TanvKT/DroneProjectHardware/README.md

# DroneProjectHardware
PCB schematic and design for Drone Project
