TanvKT/DroneProjectHardware/Controller/Controller.kicad_pcb

## KiCad design Controller/Controller.kicad_pcb (2026-02-24)

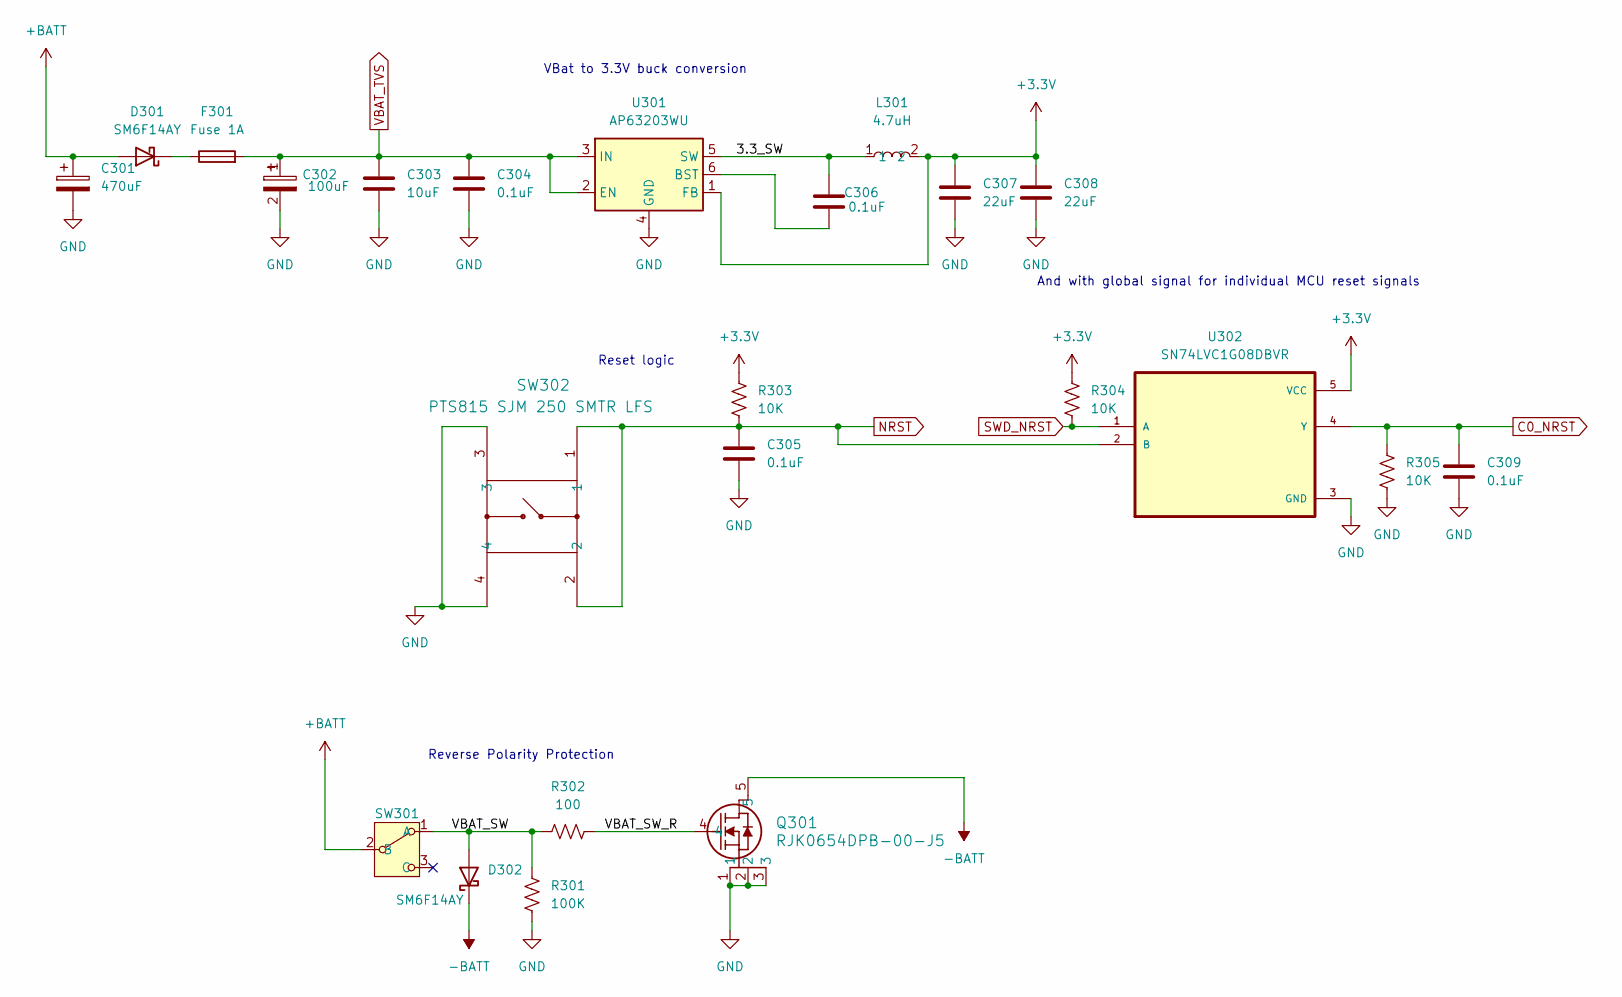
[picture p1: schematic Power.kicad_sch]

Parts:
C301: 470uF; CP_Elec_10x10.5
C302: 100uF; CAP_A768EB_6.8x6.8_KEM
C303: 10uF; C_1206_3216Metric
C304, C305, C306, C309: 0.1uF; C_0402_1005Metric
C307, C308: 22uF; C_0603_1608Metric
D301, D302: SM6F14AY; D_SOD-128
F301: Fuse 1A; Fuse_1812_4532Metric
L301: 4.7uH; IND_VLS6045EX-4R7M_TDK
Q301: RJK0654DPB-00-J5; LFPAK_REN
R301: 100K; R_0402_1005Metric
R302: 100; R_0201_0603Metric
R303, R304, R305: 10K; R_0402_1005Metric
SW301: SW_EG1218
SW302: PTS815 SJM 250 SMTR LFS; SW4_PTS815 SJM 250 SMTR LFS_CNK
U301: AP63203WU; TSOT-23-6
U302: SN74LVC1G08DBVR; SOT95P280X145-5N

Connections:
+3.3V: C307.1, C308.1, L301.2, R303.2, R304.2, U301.1 (FB), U302.5 (VCC); also elsewhere on the board
+BATT: C301.1, D301.2 (A), SW301.2 (B); also elsewhere on the board
-BATT: D302.1 (K), Q301.5; also elsewhere on the board
/Power/3.3_SW: C306.2, L301.1, U301.5 (SW)
/Power/VBAT_SW: D302.2 (A), R301.1, R302.1, SW301.1 (A)
/Power/VBAT_SW_R: Q301.4, R302.2
C0_NRST: C309.1, R305.2, U302.4 (Y); also elsewhere on the board
GND: C301.2, C302.2, C303.2, C304.2, C305.2, C307.2, C308.2, C309.2, Q301.1, Q301.2, Q301.3, R301.2, R305.1, SW302.3, SW302.4, U301.4 (GND), U302.3 (GND); also elsewhere on the board
NRST: C305.1, R303.1, SW302.1, SW302.2, U302.2 (B)
unnamed: D301.1 (K), F301.1
unnamed: C306.1, U301.6 (BST)
SWD_NRST: R304.1, U302.1 (A); also elsewhere on the board
VBAT_TVS: C302.1, C303.1, C304.1, F301.2, U301.2 (EN), U301.3 (IN); also elsewhere on the board

Notes on the sheet:
Reverse Polarity Protection
VBat to 3.3V buck conversion
And with global signal for individual MCU reset signals
Reset logic

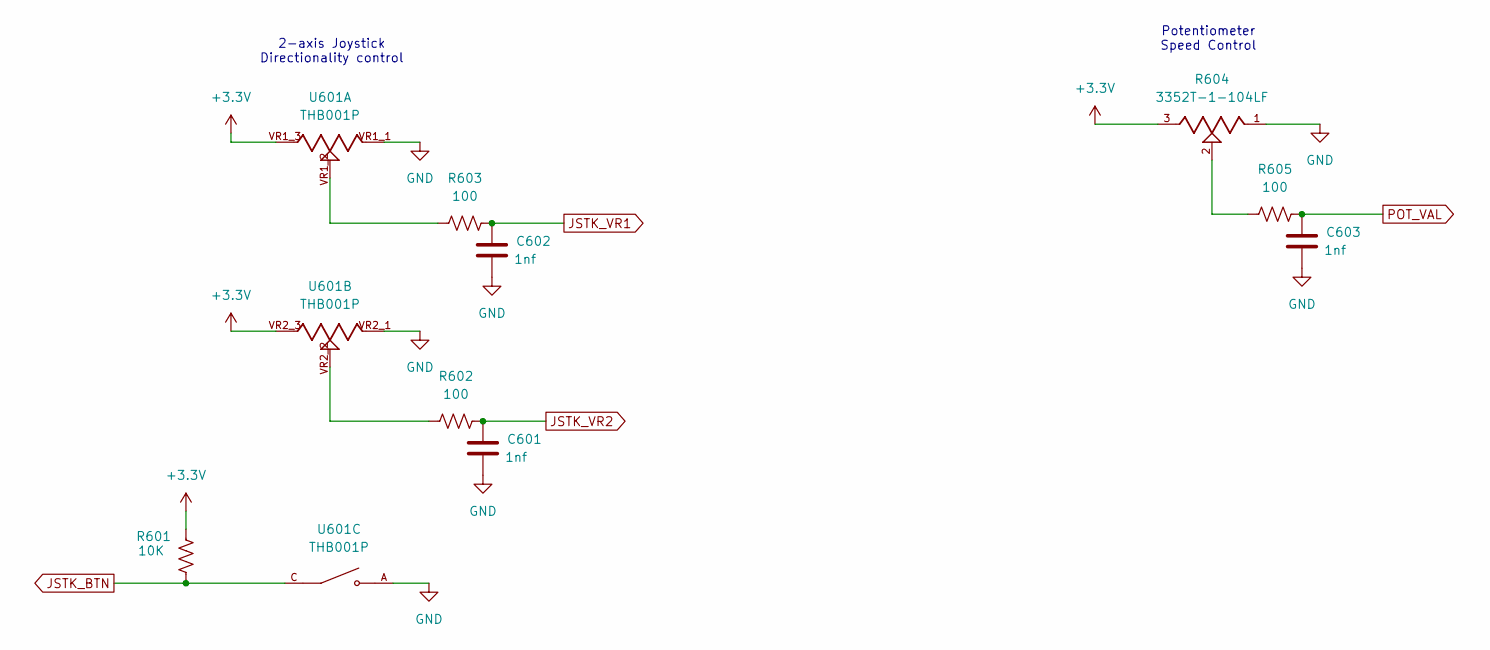
[picture p2: schematic Peripherals.kicad_sch]

Parts:
C601, C602, C603: 1nf; C_0402_1005Metric
R601: 10K; R_0402_1005Metric
R602, R603, R605: 100; R_0402_1005Metric
R604: 3352T-1-104LF; TRIM_3352T-1-104LF; PARTREV 08/19
U601: THB001P; CNK_THB001P; PARTREV 27 Jan 22

Connections:
+3.3V: R601.2, R604.3, U601.VR1_3, U601.VR2_3; also elsewhere on the board
GND: C601.2, C602.2, C603.2, R604.1, U601.A, U601.VR1_1, U601.VR2_1; also elsewhere on the board
JSTK_BTN: R601.1, U601.C; also elsewhere on the board
JSTK_VR1: C602.1, R603.2; also elsewhere on the board
JSTK_VR2: C601.1, R602.2; also elsewhere on the board
unnamed: R602.1, U601.VR2_2
unnamed: R603.1, U601.VR1_2
unnamed: R604.2, R605.1
POT_VAL: C603.1, R605.2; also elsewhere on the board

Notes on the sheet:
2-axis Joystick Directionality control
Potentiometer Speed Control

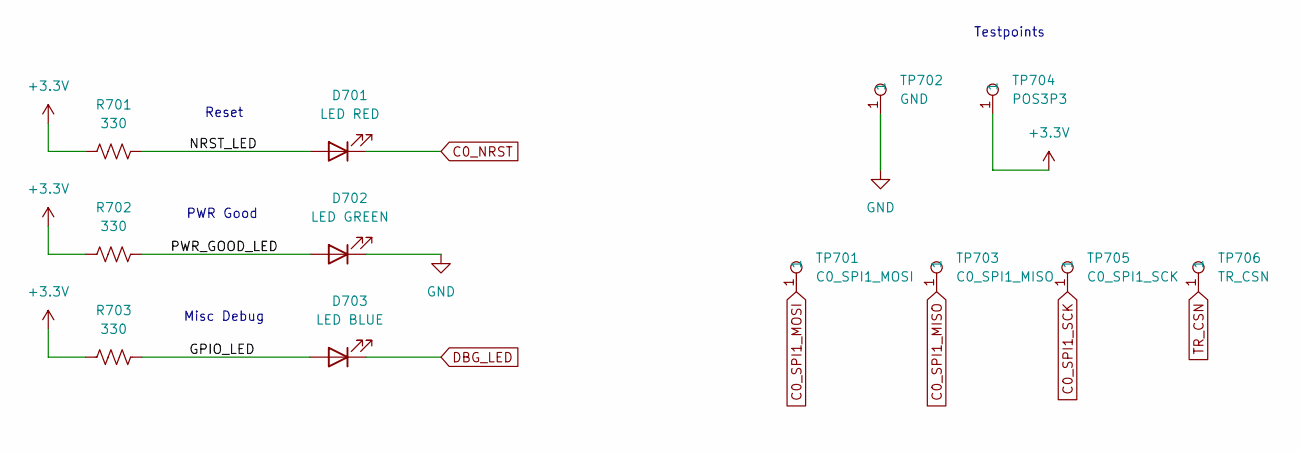
[picture p3: schematic Debug.kicad_sch]

Parts:
D701: LED RED; LED_0603_1608Metric
D702: LED GREEN; LED_0603_1608Metric
D703: LED BLUE; LED_0603_1608Metric
R701, R702, R703: 330; R_0402_1005Metric
TP701: C0_SPI1_MOSI; Testpoint 1.6mm x 0.8mm
TP702: GND; Testpoint 1.6mm x 0.8mm
TP703: C0_SPI1_MISO; Testpoint 1.6mm x 0.8mm
TP704: POS3P3; Testpoint 1.6mm x 0.8mm
TP705: C0_SPI1_SCK; Testpoint 1.6mm x 0.8mm
TP706: TR_CSN; Testpoint 1.6mm x 0.8mm

Connections:
+3.3V: R701.1, R702.1, R703.1, TP704.1; also elsewhere on the board
/Debug/GPIO_LED: D703.2 (A), R703.2
/Debug/NRST_LED: D701.2 (A), R701.2
/Debug/PWR_GOOD_LED: D702.2 (A), R702.2
C0_NRST: D701.1 (K); also elsewhere on the board
C0_SPI1_MISO: TP703.1; also elsewhere on the board
C0_SPI1_MOSI: TP701.1; also elsewhere on the board
C0_SPI1_SCK: TP705.1; also elsewhere on the board
DBG_LED: D703.1 (K); also elsewhere on the board
GND: D702.1 (K), TP702.1; also elsewhere on the board
TR_CSN: TP706.1; also elsewhere on the board

Notes on the sheet:
Misc Debug
Testpoints
PWR Good
Reset

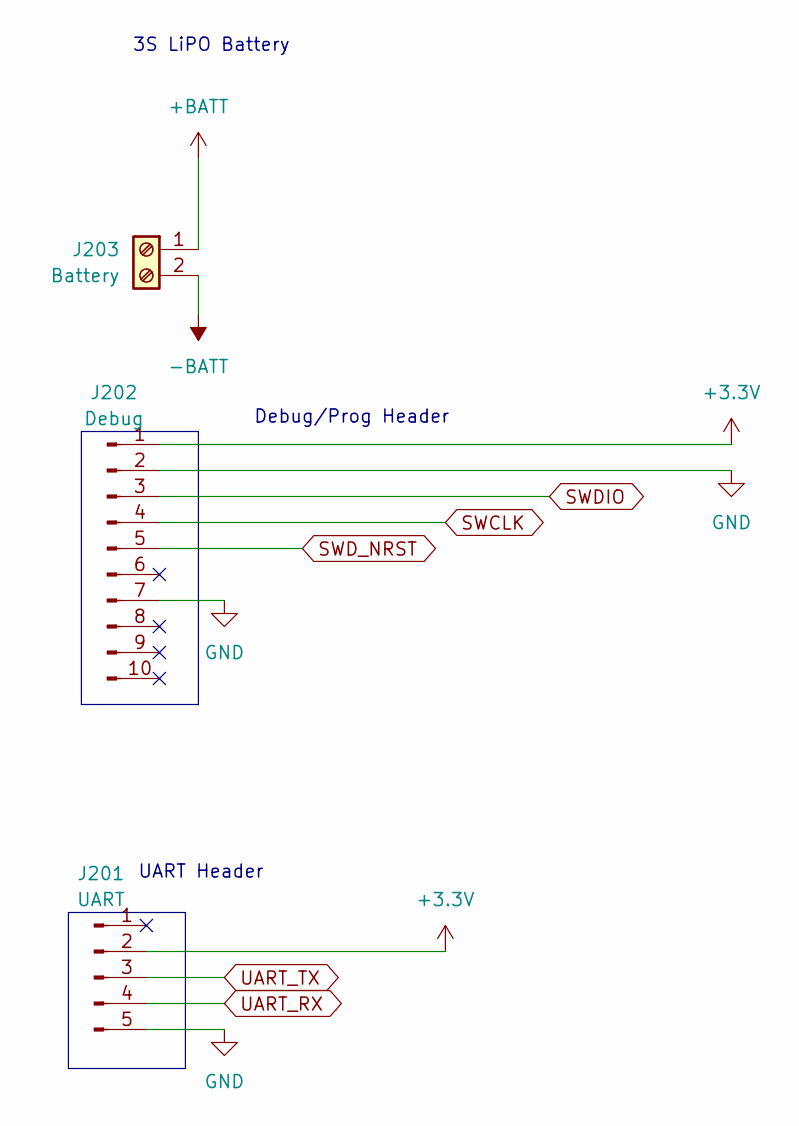
[picture p4: schematic Connectors.kicad_sch]

Parts:
J201: UART; PinHeader_1x05_P2.54mm_Vertical
J202: Debug; PinHeader_2x05_P2.54mm_Vertical
J203: Battery; CUI_TB002-500-02BE

Connections:
+3.3V: J201.2, J202.1; also elsewhere on the board
+BATT: J203.1; also elsewhere on the board
-BATT: J203.2; also elsewhere on the board
GND: J201.5, J202.2, J202.7; also elsewhere on the board
SWCLK: J202.4; also elsewhere on the board
SWDIO: J202.3; also elsewhere on the board
SWD_NRST: J202.5; also elsewhere on the board
UART_RX: J201.4; also elsewhere on the board
UART_TX: J201.3; also elsewhere on the board

Notes on the sheet:
UART Header
3S LiPO Battery
Debug/Prog Header

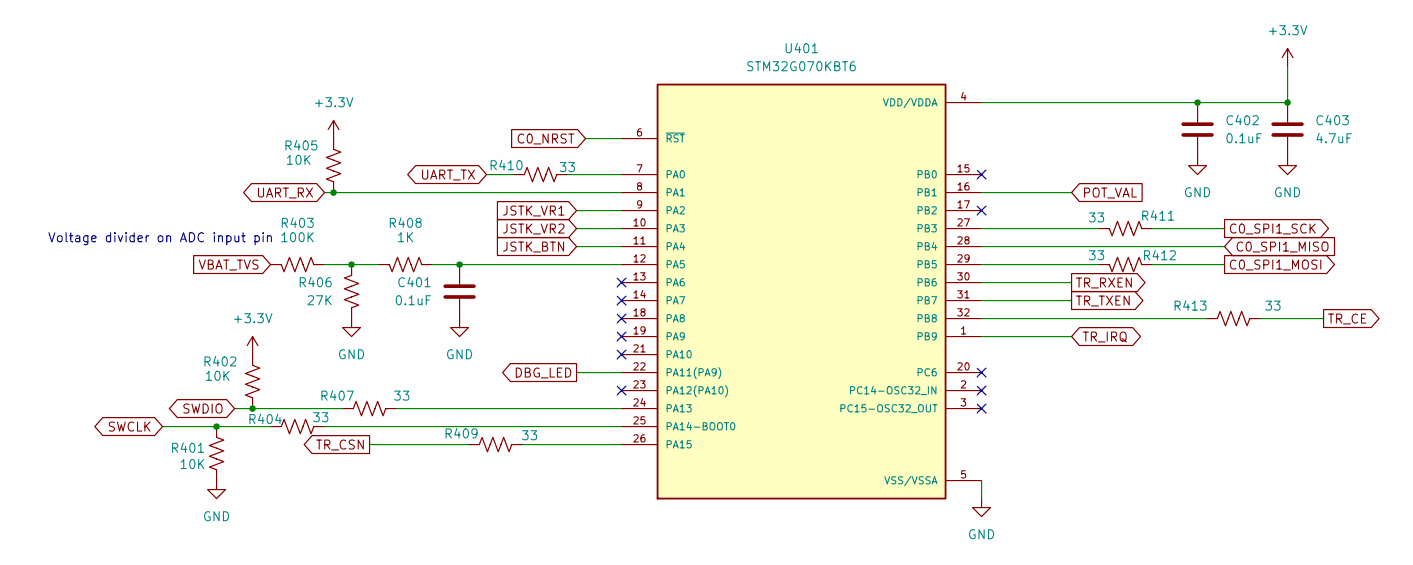
[picture p5: schematic MCU.kicad_sch]

Parts:
C401, C402: 0.1uF; C_0402_1005Metric
C403: 4.7uF; C_0805_2012Metric
R401, R402, R405: 10K; R_0402_1005Metric
R403: 100K; R_0402_1005Metric
R404, R407, R409, R410, R411, R412, R413: 33; R_0402_1005Metric
R406: 27K; R_0402_1005Metric
R408: 1K; R_0402_1005Metric
U401: STM32G070KBT6; QFP80P900X900X160-32N; PARTREV 2

Connections:
+3.3V: C402.1, C403.1, R402.2, R405.2, U401.4 (VDD/VDDA); also elsewhere on the board
C0_NRST: U401.6 (~RST); also elsewhere on the board
C0_SPI1_MISO: U401.28 (PB4); also elsewhere on the board
C0_SPI1_MOSI: R412.1; also elsewhere on the board
C0_SPI1_SCK: R411.1; also elsewhere on the board
DBG_LED: U401.22 (PA11(PA9)); also elsewhere on the board
GND: C401.2, C402.2, C403.2, R401.1, R406.1, U401.5 (VSS/VSSA); also elsewhere on the board
JSTK_BTN: U401.11 (PA4); also elsewhere on the board
JSTK_VR1: U401.9 (PA2); also elsewhere on the board
JSTK_VR2: U401.10 (PA3); also elsewhere on the board
unnamed: R403.1, R406.2, R408.2
unnamed: R410.2, U401.7 (PA0)
unnamed: C401.1, R408.1, U401.12 (PA5)
unnamed: R407.2, U401.24 (PA13)
unnamed: R404.2, U401.25 (PA14-BOOT0)
unnamed: R409.2, U401.26 (PA15)
unnamed: R411.2, U401.27 (PB3)
unnamed: R412.2, U401.29 (PB5)
unnamed: R413.1, U401.32 (PB8)
POT_VAL: U401.16 (PB1); also elsewhere on the board
SWCLK: R401.2, R404.1; also elsewhere on the board
SWDIO: R402.1, R407.1; also elsewhere on the board
TR_CE: R413.2; also elsewhere on the board
TR_CSN: R409.1; also elsewhere on the board
TR_IRQ: U401.1 (PB9); also elsewhere on the board
TR_RXEN: U401.30 (PB6); also elsewhere on the board
TR_TXEN: U401.31 (PB7); also elsewhere on the board
UART_RX: R405.1, U401.8 (PA1); also elsewhere on the board
UART_TX: R410.1; also elsewhere on the board
VBAT_TVS: R403.2; also elsewhere on the board

Notes on the sheet:
Voltage divider on ADC input pin

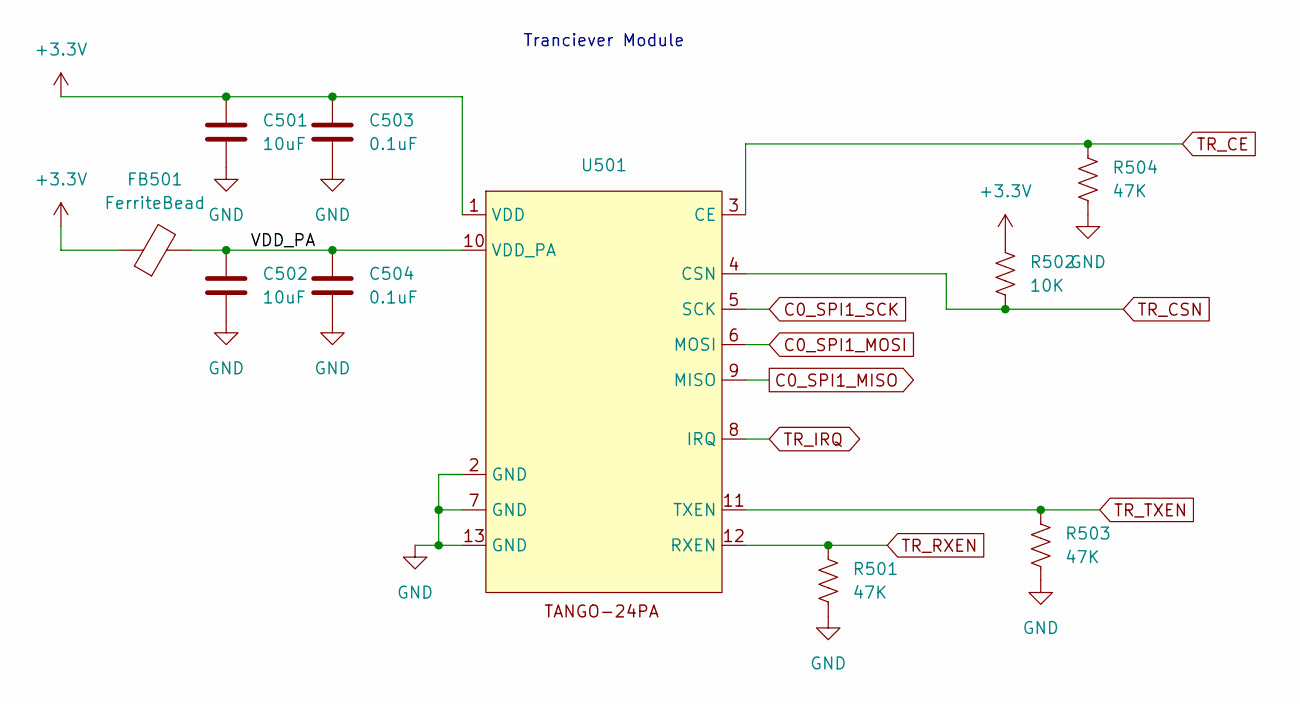
[picture p6: schematic Transciever.kicad_sch]

Parts:
C501, C502: 10uF; C_1206_3216Metric
C503, C504: 0.1uF; C_0402_1005Metric
FB501: FerriteBead; L_0805_2012Metric
R501, R503, R504: 47K; R_0402_1005Metric
R502: 10K; R_0402_1005Metric
U501: TANGO-24PA

Connections:
+3.3V: C501.1, C503.1, FB501.1, R502.2, U501.1 (VDD); also elsewhere on the board
/Transciever/VDD_PA: C502.1, C504.1, FB501.2, U501.10 (VDD_PA)
C0_SPI1_MISO: U501.9 (MISO); also elsewhere on the board
C0_SPI1_MOSI: U501.6 (MOSI); also elsewhere on the board
C0_SPI1_SCK: U501.5 (SCK); also elsewhere on the board
GND: C501.2, C502.2, C503.2, C504.2, R501.2, R503.2, R504.2, U501.2 (GND), U501.7 (GND), U501.13 (GND); also elsewhere on the board
TR_CE: R504.1, U501.3 (CE); also elsewhere on the board
TR_CSN: R502.1, U501.4 (CSN); also elsewhere on the board
TR_IRQ: U501.8 (IRQ); also elsewhere on the board
TR_RXEN: R501.1, U501.12 (RXEN); also elsewhere on the board
TR_TXEN: R503.1, U501.11 (TXEN); also elsewhere on the board

Notes on the sheet:
Tranciever Module

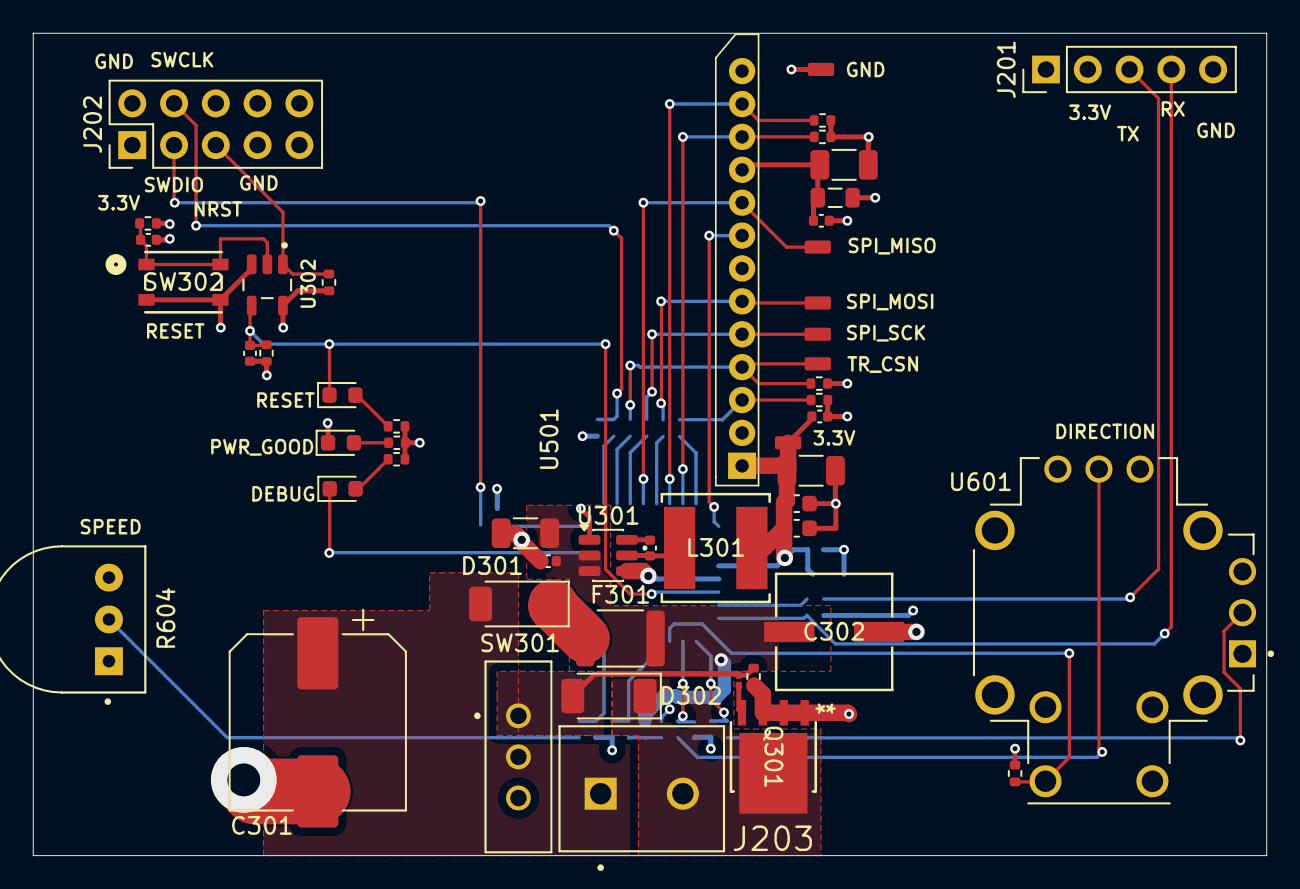
[picture p7: board Controller.kicad_pcb from above]

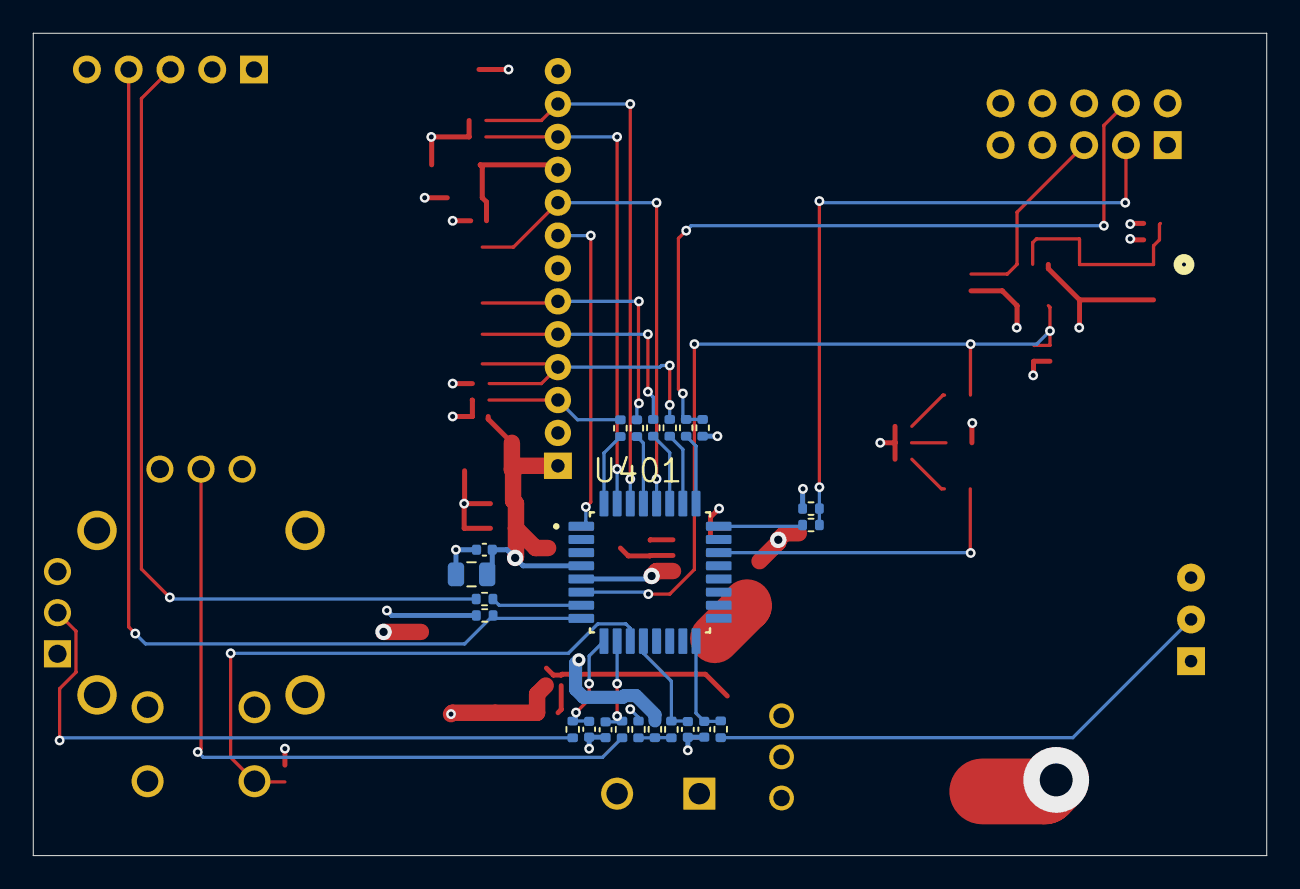
[picture p8: board Controller.kicad_pcb from below]

Board: 4 copper layers, 75.0 x 50.0 mm, 74 parts (23 on the bottom side), 46 nets.
