TanvKT/DroneProjectHardware/DroneProject/DroneProject.kicad_pcb

## KiCad design DroneProject/DroneProject.kicad_pcb (2026-02-22)

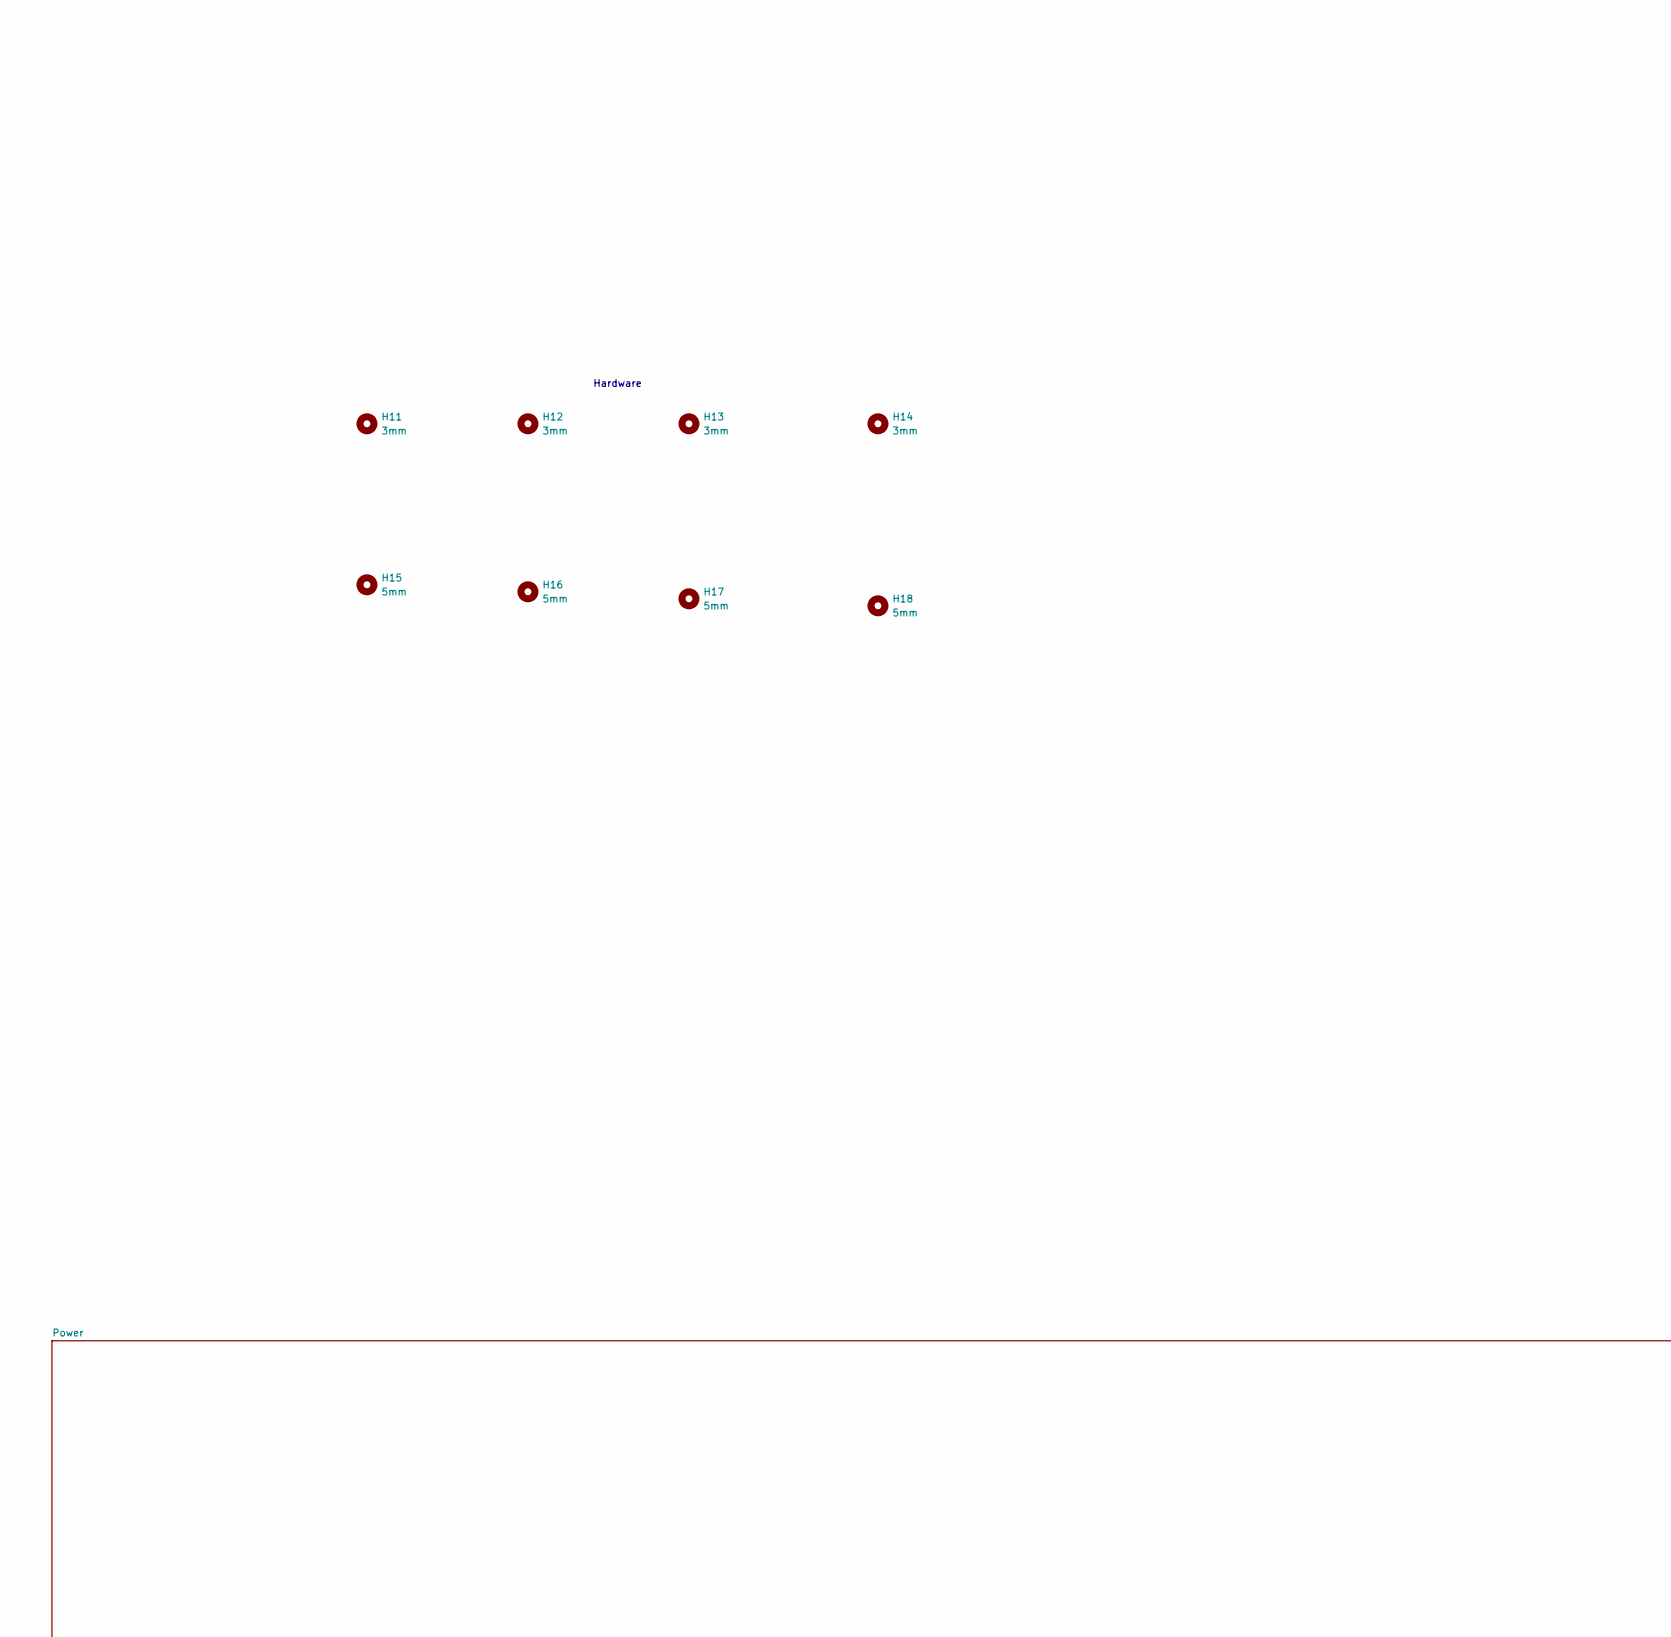
[picture p9: schematic DroneProject.kicad_sch, part in row 1, column 1]

Parts:
H11, H12, H13, H14: 3mm; MountingHole_3mm
H15, H16, H17, H18: 5mm; MountingHole_5mm

Notes on the sheet:
Hardware

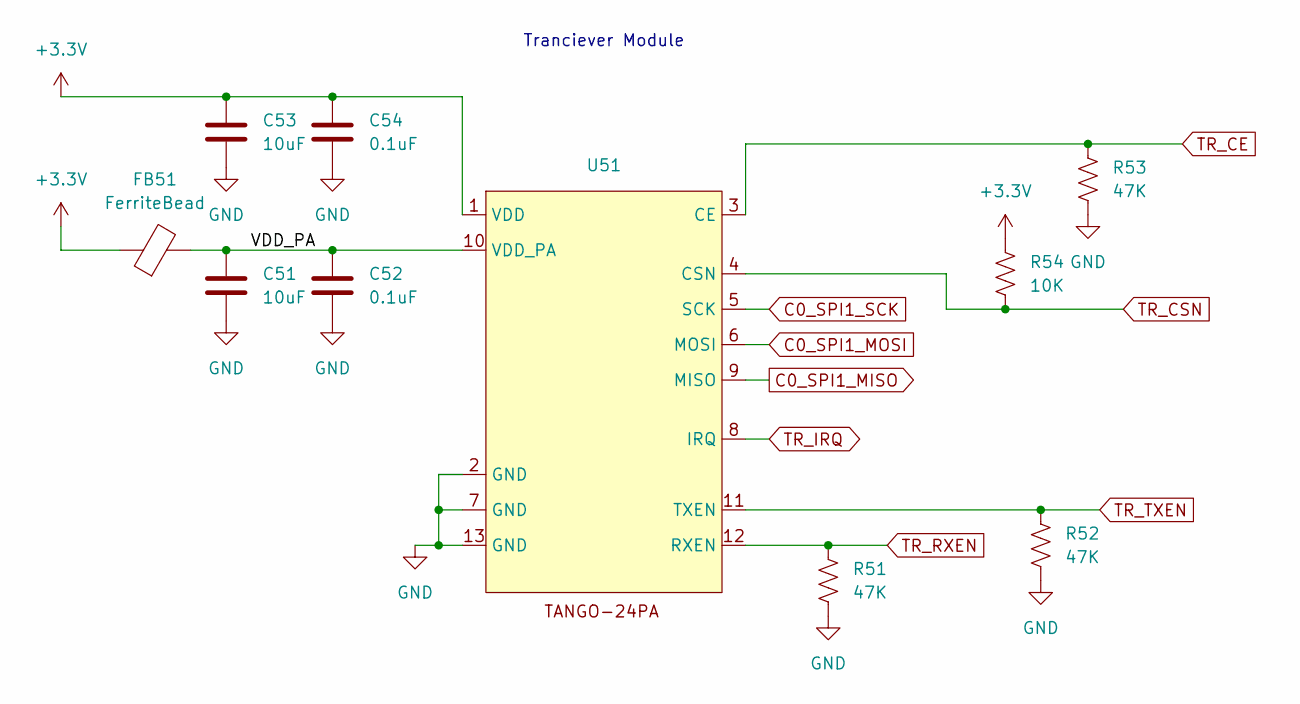
[picture p10: schematic Transciever.kicad_sch]

Parts:
C51, C53: 10uF; C_1206_3216Metric
C52, C54: 0.1uF; C_0402_1005Metric
FB51: FerriteBead; L_0805_2012Metric
R51, R52, R53: 47K; R_0402_1005Metric
R54: 10K; R_0402_1005Metric
U51: TANGO-24PA

Connections:
+3.3V: C53.1, C54.1, FB51.1, R54.2, U51.1 (VDD); also elsewhere on the board
/Transciever/VDD_PA: C51.1, C52.1, FB51.2, U51.10 (VDD_PA)
C0_SPI1_MISO: U51.9 (MISO); also elsewhere on the board
C0_SPI1_MOSI: U51.6 (MOSI); also elsewhere on the board
C0_SPI1_SCK: U51.5 (SCK); also elsewhere on the board
GND: C51.2, C52.2, C53.2, C54.2, R51.2, R52.2, R53.2, U51.2 (GND), U51.7 (GND), U51.13 (GND); also elsewhere on the board
TR_CE: R53.1, U51.3 (CE); also elsewhere on the board
TR_CSN: R54.1, U51.4 (CSN); also elsewhere on the board
TR_IRQ: U51.8 (IRQ); also elsewhere on the board
TR_RXEN: R51.1, U51.12 (RXEN); also elsewhere on the board
TR_TXEN: R52.1, U51.11 (TXEN); also elsewhere on the board

Notes on the sheet:
Tranciever Module

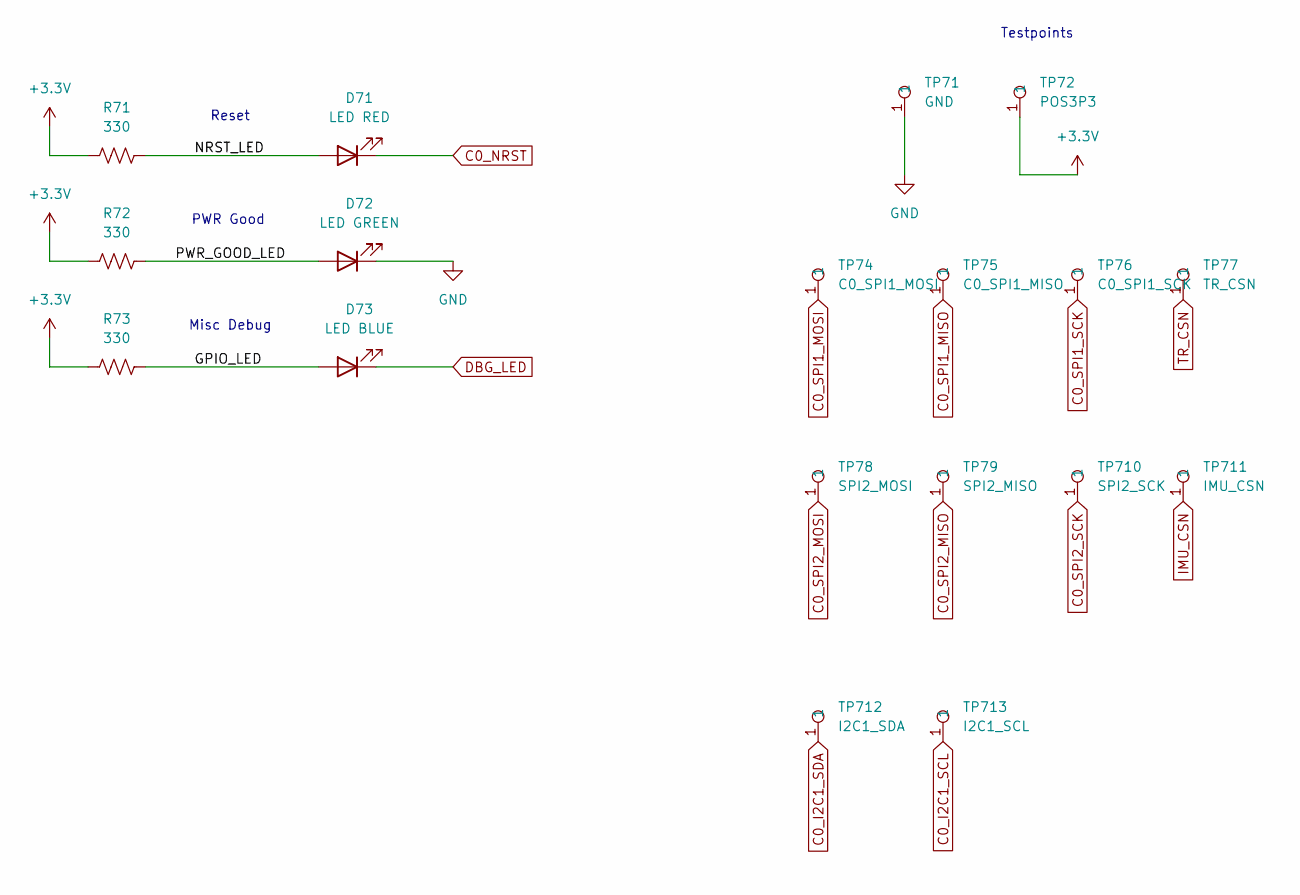
[picture p11: schematic Debug.kicad_sch]

Parts:
D71: LED RED; LED_0603_1608Metric
D72: LED GREEN; LED_0603_1608Metric
D73: LED BLUE; LED_0603_1608Metric
R71, R72, R73: 330; R_0402_1005Metric
TP71: GND; Testpoint 1.6mm x 0.8mm
TP72: POS3P3; Testpoint 1.6mm x 0.8mm
TP74: C0_SPI1_MOSI; Testpoint 1.6mm x 0.8mm
TP75: C0_SPI1_MISO; Testpoint 1.6mm x 0.8mm
TP76: C0_SPI1_SCK; Testpoint 1.6mm x 0.8mm
TP77: TR_CSN; Testpoint 1.6mm x 0.8mm
TP78: SPI2_MOSI; Testpoint 1.6mm x 0.8mm
TP79: SPI2_MISO; Testpoint 1.6mm x 0.8mm
TP710: SPI2_SCK; Testpoint 1.6mm x 0.8mm
TP711: IMU_CSN; Testpoint 1.6mm x 0.8mm
TP712: I2C1_SDA; Testpoint 1.6mm x 0.8mm
TP713: I2C1_SCL; Testpoint 1.6mm x 0.8mm

Connections:
+3.3V: R71.1, R72.1, R73.1, TP72.1; also elsewhere on the board
/Debug/GPIO_LED: D73.2 (A), R73.2
/Debug/NRST_LED: D71.2 (A), R71.2
/Debug/PWR_GOOD_LED: D72.2 (A), R72.2
C0_I2C1_SCL: TP713.1; also elsewhere on the board
C0_I2C1_SDA: TP712.1; also elsewhere on the board
C0_NRST: D71.1 (K); also elsewhere on the board
C0_SPI1_MISO: TP75.1; also elsewhere on the board
C0_SPI1_MOSI: TP74.1; also elsewhere on the board
C0_SPI1_SCK: TP76.1; also elsewhere on the board
C0_SPI2_MISO: TP79.1; also elsewhere on the board
C0_SPI2_MOSI: TP78.1; also elsewhere on the board
C0_SPI2_SCK: TP710.1; also elsewhere on the board
DBG_LED: D73.1 (K); also elsewhere on the board
GND: D72.1 (K), TP71.1; also elsewhere on the board
IMU_CSN: TP711.1; also elsewhere on the board
TR_CSN: TP77.1; also elsewhere on the board

Notes on the sheet:
Misc Debug
Reset
Testpoints
PWR Good

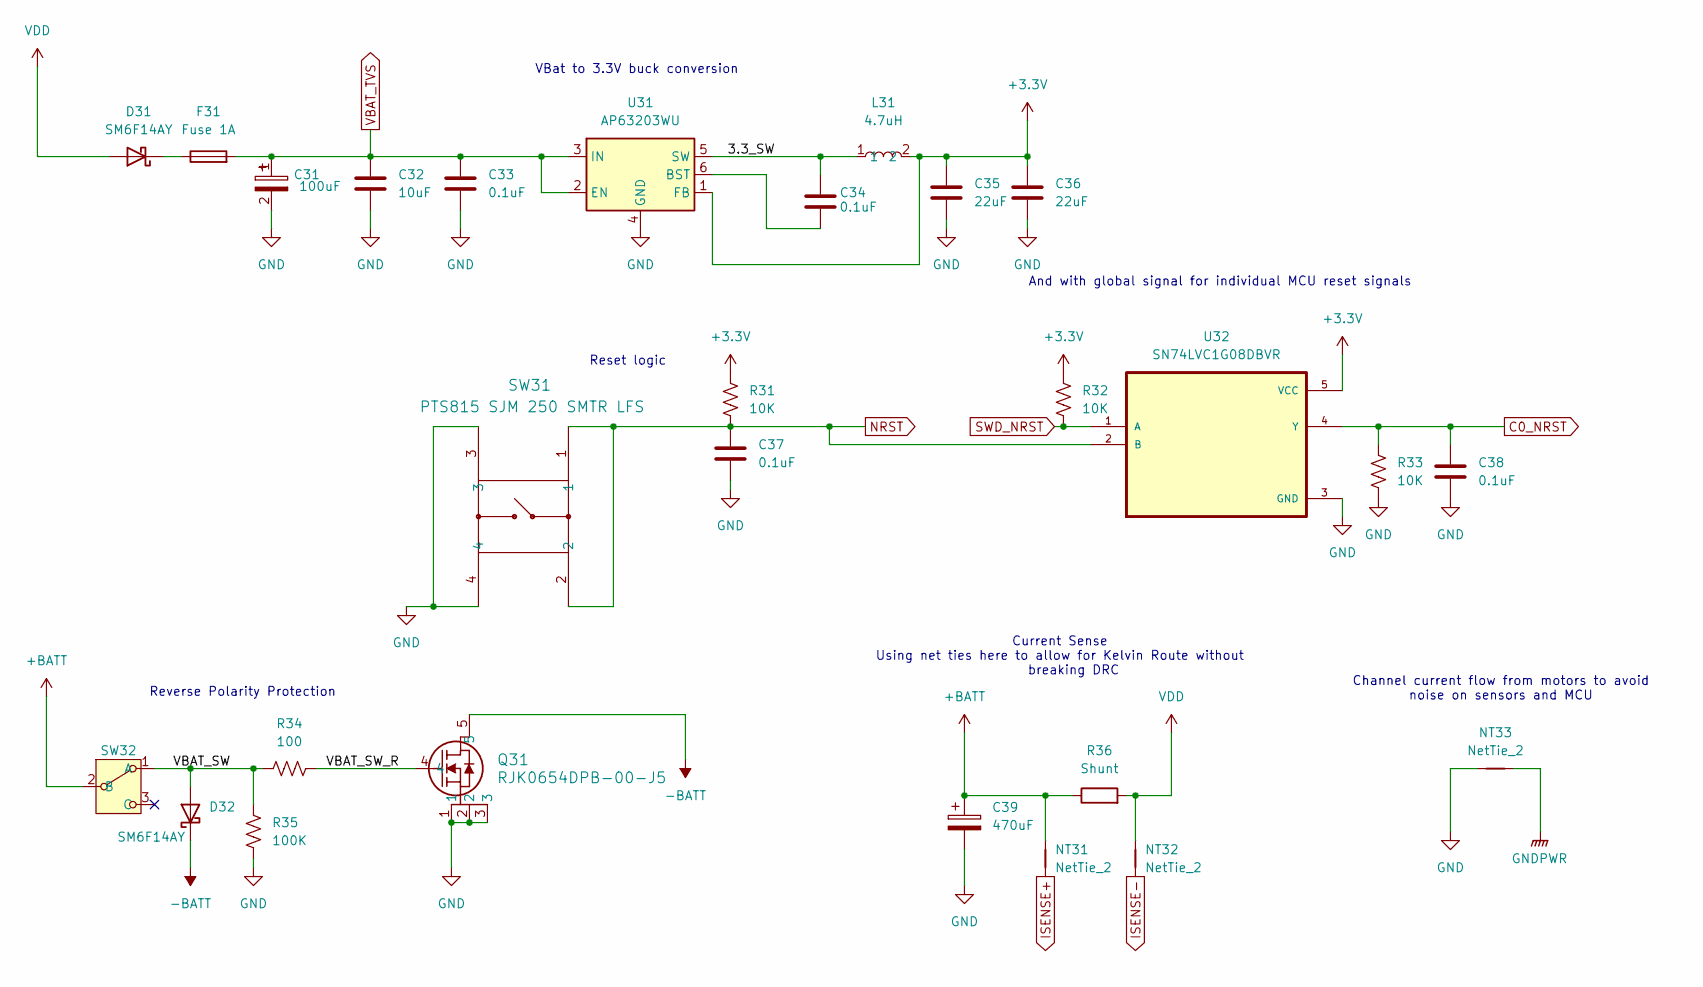
[picture p12: schematic Power.kicad_sch]

Parts:
C31: 100uF; CAP_A768EB_6.8x6.8_KEM
C32: 10uF; C_1206_3216Metric
C33, C34, C37, C38: 0.1uF; C_0402_1005Metric
C35, C36: 22uF; C_0603_1608Metric
C39: 470uF; CP_Elec_10x10.5
D31, D32: SM6F14AY; D_SOD-128
F31: Fuse 1A; Fuse_1812_4532Metric
L31: 4.7uH; IND_VLS6045EX-4R7M_TDK
NT31, NT32: NetTie_2; NetTie-2_SMD_Pad0.5mm
NT33: NetTie_2; NetTie-2_SMD_Pad2.0mm
Q31: RJK0654DPB-00-J5; LFPAK_REN
R31, R32, R33: 10K; R_0402_1005Metric
R34: 100; R_0201_0603Metric
R35: 100K; R_0402_1005Metric
R36: Shunt; R_2010_5025Metric
SW31: PTS815 SJM 250 SMTR LFS; SW4_PTS815 SJM 250 SMTR LFS_CNK
SW32: SW_EG1218
U31: AP63203WU; TSOT-23-6
U32: SN74LVC1G08DBVR; SOT95P280X145-5N

Connections:
+3.3V: C35.1, C36.1, L31.2, R31.2, R32.2, U31.1 (FB), U32.5 (VCC); also elsewhere on the board
+BATT: C39.1, NT31.2, R36.1, SW32.2 (B); also elsewhere on the board
-BATT: D32.1 (K), Q31.5; also elsewhere on the board
/Power/3.3_SW: C34.2, L31.1, U31.5 (SW)
/Power/VBAT_SW: D32.2 (A), R34.1, R35.1, SW32.1 (A)
/Power/VBAT_SW_R: Q31.4, R34.2
C0_NRST: C38.1, R33.2, U32.4 (Y); also elsewhere on the board
GND: C31.2, C32.2, C33.2, C35.2, C36.2, C37.2, C38.2, C39.2, NT33.2, Q31.1, Q31.2, Q31.3, R33.1, R35.2, SW31.3, SW31.4, U31.4 (GND), U32.3 (GND); also elsewhere on the board
GNDPWR: NT33.1; also elsewhere on the board
ISENSE+: NT31.1; also elsewhere on the board
ISENSE-: NT32.1; also elsewhere on the board
NRST: C37.1, R31.1, SW31.1, SW31.2, U32.2 (B)
unnamed: D31.1 (K), F31.1
unnamed: C34.1, U31.6 (BST)
SWD_NRST: R32.1, U32.1 (A); also elsewhere on the board
VBAT_TVS: C31.1, C32.1, C33.1, F31.2, U31.2 (EN), U31.3 (IN); also elsewhere on the board
VDD: D31.2 (A), NT32.2, R36.2; also elsewhere on the board

Notes on the sheet:
And with global signal for individual MCU reset signals
Reset logic
Reverse Polarity Protection
VBat to 3.3V buck conversion
Current Sense Using net ties here to allow for Kelvin Route without breaking DRC
Channel current flow from motors to avoid noise on sensors and MCU
