TanvKT/DroneProjectHardware/DroneProject/DroneProject.kicad_pcb

## KiCad design DroneProject/DroneProject.kicad_pcb (continued)

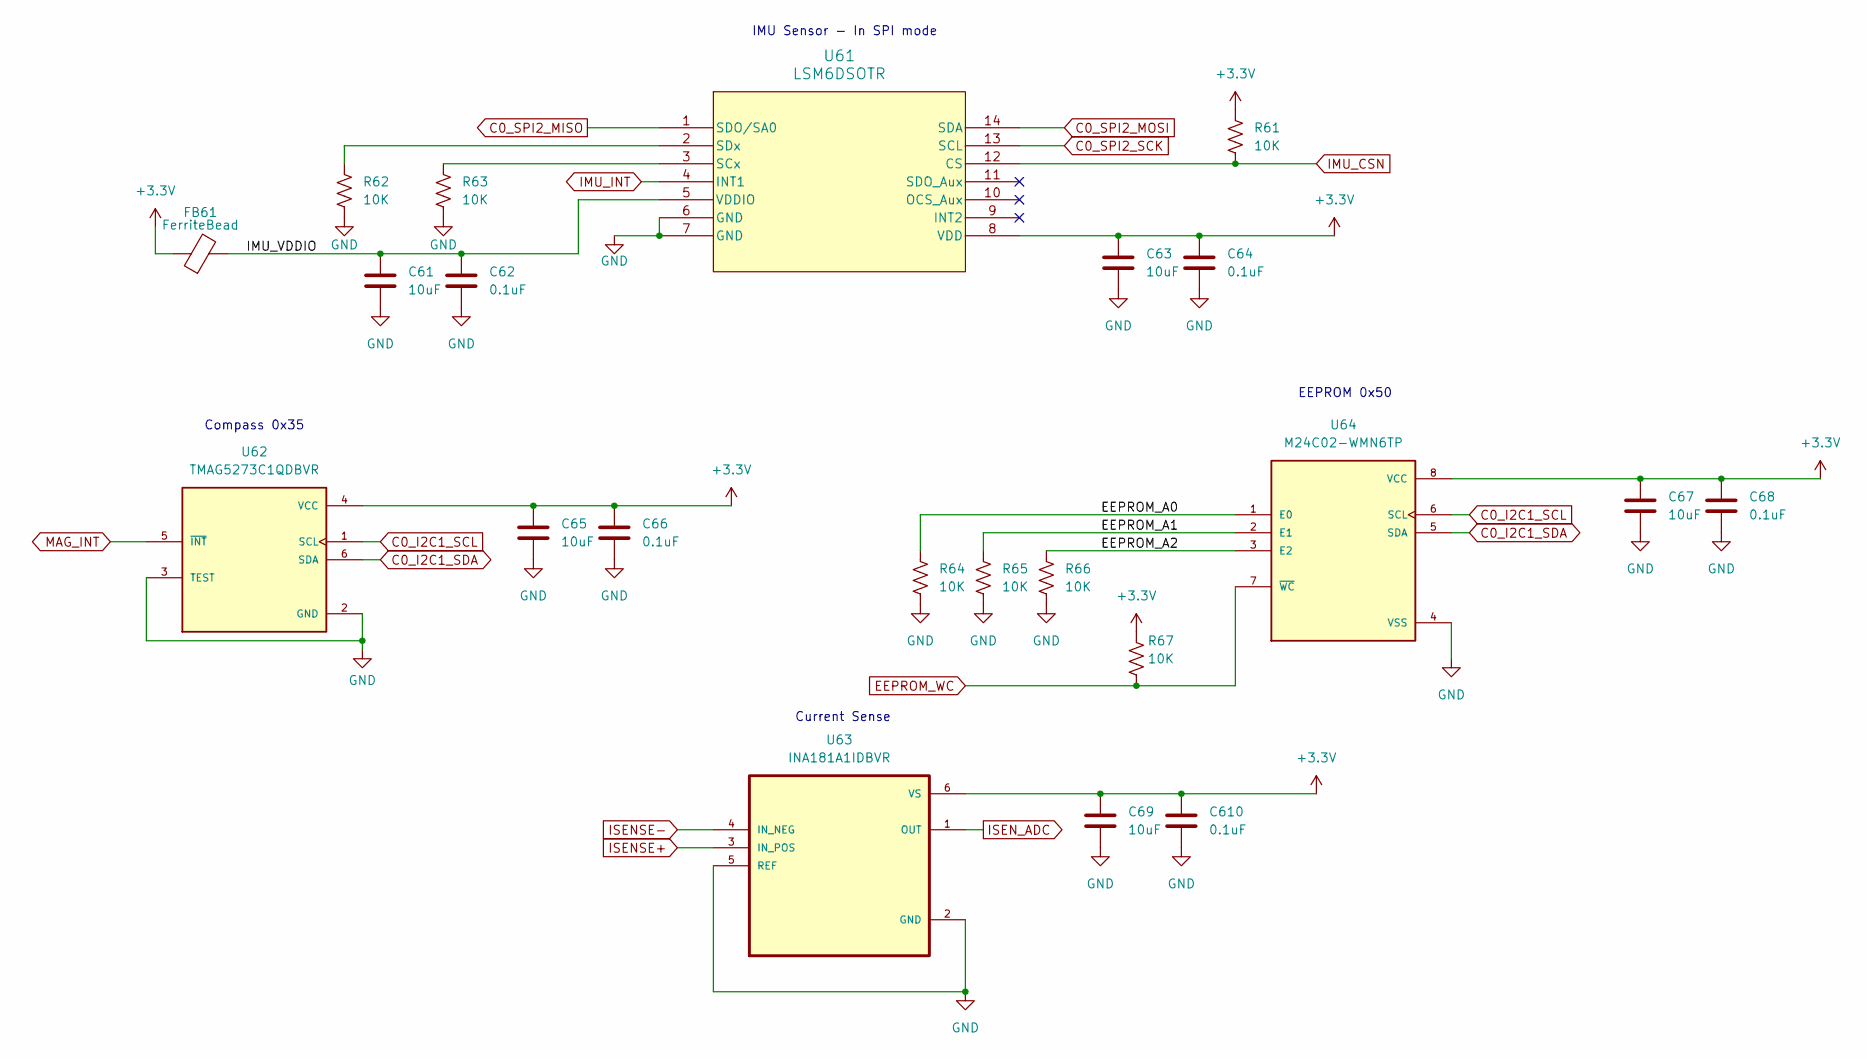
[picture p13: schematic Sensors.kicad_sch, Peripherals]

Parts:
C61, C63, C65, C67, C69: 10uF; C_1206_3216Metric
C62, C64, C66, C68, C610: 0.1uF; C_0402_1005Metric
FB61: FerriteBead; L_0805_2012Metric
R61, R62, R63, R64, R65, R66, R67: 10K; R_0402_1005Metric
U61: LSM6DSOTR; LGA-14L_2P5X3X0P86_STM
U62: TMAG5273C1QDBVR; SOT95P280X140-6N; PARTREV B
U63: INA181A1IDBVR; SOT95P280X145-6N
U64: M24C02-WMN6TP; SOIC127P600X175-8N; PARTREV 8

Connections:
+3.3V: C63.1, C64.1, C65.1, C66.1, C67.1, C68.1, C69.1, C610.1, FB61.1, R61.2, R67.2, U61.8 (VDD), U62.4 (VCC), U63.6 (VS), U64.8 (VCC); also elsewhere on the board
/Peripherals/EEPROM_A0: R64.2, U64.1 (E0)
/Peripherals/EEPROM_A1: R65.2, U64.2 (E1)
/Peripherals/EEPROM_A2: R66.2, U64.3 (E2)
/Peripherals/IMU_VDDIO: C61.1, C62.1, FB61.2, U61.5 (VDDIO)
C0_I2C1_SCL: U62.1 (SCL), U64.6 (SCL); also elsewhere on the board
C0_I2C1_SDA: U62.6 (SDA), U64.5 (SDA); also elsewhere on the board
C0_SPI2_MISO: U61.1 (SDO/SA0); also elsewhere on the board
C0_SPI2_MOSI: U61.14 (SDA); also elsewhere on the board
C0_SPI2_SCK: U61.13 (SCL); also elsewhere on the board
EEPROM_WC: R67.1, U64.7 (~WC); also elsewhere on the board
GND: C61.2, C62.2, C63.2, C64.2, C65.2, C66.2, C67.2, C68.2, C69.2, C610.2, R62.1, R63.1, R64.1, R65.1, R66.1, U61.6 (GND), U61.7 (GND), U62.2 (GND), U62.3 (TEST), U63.2 (GND), U63.5 (REF), U64.4 (VSS); also elsewhere on the board
IMU_CSN: R61.1, U61.12 (CS); also elsewhere on the board
IMU_INT: U61.4 (INT1); also elsewhere on the board
ISENSE+: U63.3 (IN_POS); also elsewhere on the board
ISENSE-: U63.4 (IN_NEG); also elsewhere on the board
ISEN_ADC: U63.1 (OUT); also elsewhere on the board
MAG_INT: U62.5 (~INT); also elsewhere on the board
unnamed: R63.2, U61.3 (SCx)
unnamed: R62.2, U61.2 (SDx)

Notes on the sheet:
IMU Sensor - In SPI mode
Compass 0x35
Current Sense
EEPROM 0x50

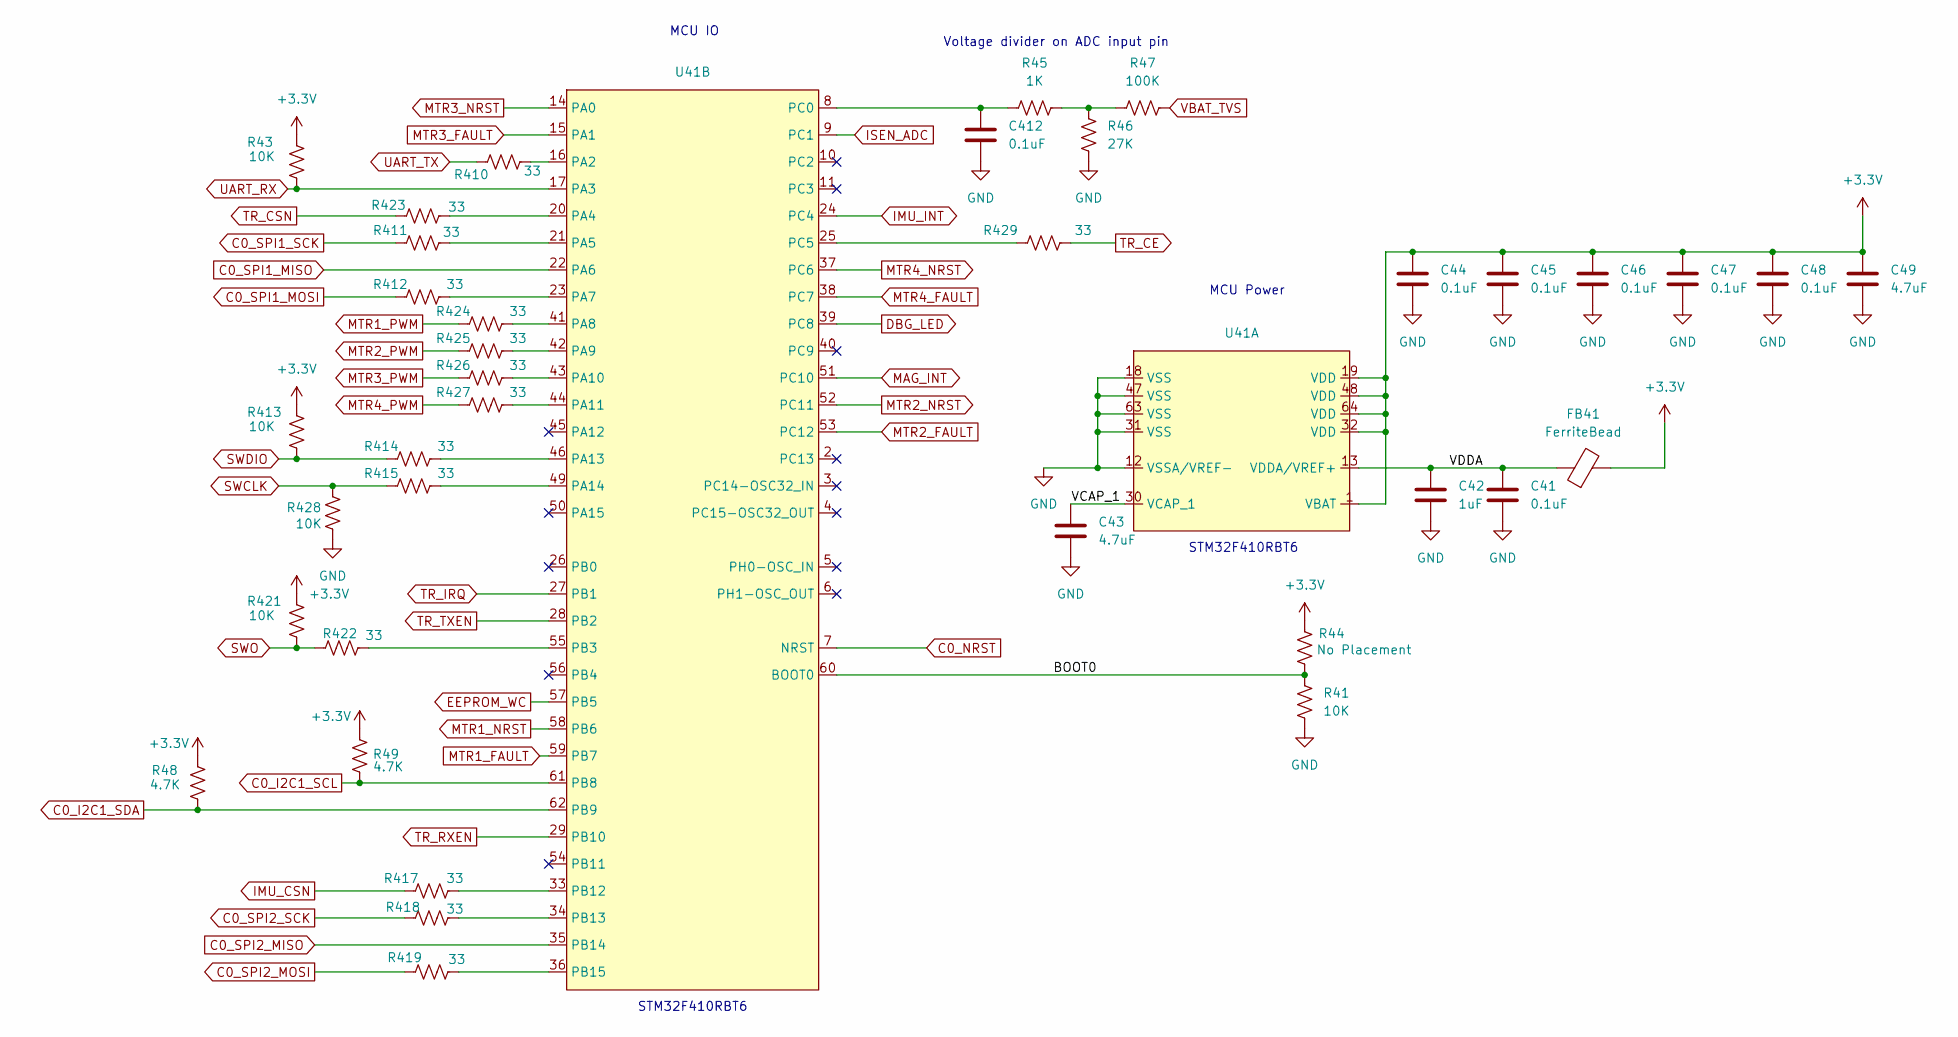
[picture p14: schematic MCU.kicad_sch]

Parts:
C41, C44, C45, C46, C47, C48, C412: 0.1uF; C_0402_1005Metric
C42: 1uF; C_0402_1005Metric
C43, C49: 4.7uF; C_0805_2012Metric
FB41: FerriteBead; L_0805_2012Metric
R41, R43, R413, R421, R428: 10K; R_0402_1005Metric
R44: No Placement; R_0402_1005Metric
R45: 1K; R_0402_1005Metric
R46: 27K; R_0402_1005Metric
R47: 100K; R_0402_1005Metric
R48, R49: 4.7K; R_0402_1005Metric
R410, R411, R412, R414, R415, R417, R418, R419, R422, R423, R424, R425, R426, R427, R429: 33; R_0402_1005Metric
U41: STM32F410RBT6; LQFP64-10x10mm

Connections:
+3.3V: C44.1, C45.1, C46.1, C47.1, C48.1, C49.1, FB41.2, R43.2, R44.2, R48.2, R49.2, R413.2, R421.2, U41.1 (VBAT), U41.19 (VDD), U41.32 (VDD), U41.48 (VDD), U41.64 (VDD); also elsewhere on the board
/MCU/BOOT0: R41.2, R44.1, U41.60 (BOOT0)
/MCU/VCAP_1: C43.1, U41.30 (VCAP_1)
/MCU/VDDA: C41.1, C42.1, FB41.1, U41.13 (VDDA/VREF+)
C0_I2C1_SCL: R49.1, U41.61 (PB8); also elsewhere on the board
C0_I2C1_SDA: R48.1, U41.62 (PB9); also elsewhere on the board
C0_NRST: U41.7 (NRST); also elsewhere on the board
C0_SPI1_MISO: U41.22 (PA6); also elsewhere on the board
C0_SPI1_MOSI: R412.1; also elsewhere on the board
C0_SPI1_SCK: R411.1; also elsewhere on the board
C0_SPI2_MISO: U41.35 (PB14); also elsewhere on the board
C0_SPI2_MOSI: R419.1; also elsewhere on the board
C0_SPI2_SCK: R418.1; also elsewhere on the board
DBG_LED: U41.39 (PC8); also elsewhere on the board
EEPROM_WC: U41.57 (PB5); also elsewhere on the board
GND: C41.2, C42.2, C43.2, C44.2, C45.2, C46.2, C47.2, C48.2, C49.2, C412.2, R41.1, R46.1, R428.1, U41.12 (VSSA/VREF-), U41.18 (VSS), U41.31 (VSS), U41.47 (VSS), U41.63 (VSS); also elsewhere on the board
IMU_CSN: R417.1; also elsewhere on the board
IMU_INT: U41.24 (PC4); also elsewhere on the board
ISEN_ADC: U41.9 (PC1); also elsewhere on the board
MAG_INT: U41.51 (PC10); also elsewhere on the board
MTR1_FAULT: U41.59 (PB7); also elsewhere on the board
MTR1_NRST: U41.58 (PB6); also elsewhere on the board
MTR1_PWM: R424.1; also elsewhere on the board
MTR2_FAULT: U41.53 (PC12); also elsewhere on the board
MTR2_NRST: U41.52 (PC11); also elsewhere on the board
MTR2_PWM: R425.1; also elsewhere on the board
MTR3_FAULT: U41.15 (PA1); also elsewhere on the board
MTR3_NRST: U41.14 (PA0); also elsewhere on the board
MTR3_PWM: R426.1; also elsewhere on the board
MTR4_FAULT: U41.38 (PC7); also elsewhere on the board
MTR4_NRST: U41.37 (PC6); also elsewhere on the board
MTR4_PWM: R427.1; also elsewhere on the board
unnamed: R45.2, R46.2, R47.1
unnamed: R410.2, U41.16 (PA2)
unnamed: R423.2, U41.20 (PA4)
unnamed: R411.2, U41.21 (PA5)
unnamed: R412.2, U41.23 (PA7)
unnamed: R424.2, U41.41 (PA8)
unnamed: R425.2, U41.42 (PA9)
unnamed: R426.2, U41.43 (PA10)
unnamed: R427.2, U41.44 (PA11)
unnamed: R414.2, U41.46 (PA13)
unnamed: R415.2, U41.49 (PA14)
unnamed: R422.2, U41.55 (PB3)
unnamed: R417.2, U41.33 (PB12)
unnamed: R418.2, U41.34 (PB13)
unnamed: R419.2, U41.36 (PB15)
unnamed: C412.1, R45.1, U41.8 (PC0)
unnamed: R429.1, U41.25 (PC5)
SWCLK: R415.1, R428.2; also elsewhere on the board
SWDIO: R413.1, R414.1; also elsewhere on the board
SWO: R421.1, R422.1; also elsewhere on the board
TR_CE: R429.2; also elsewhere on the board
TR_CSN: R423.1; also elsewhere on the board
TR_IRQ: U41.27 (PB1); also elsewhere on the board
TR_RXEN: U41.29 (PB10); also elsewhere on the board
TR_TXEN: U41.28 (PB2); also elsewhere on the board
UART_RX: R43.1, U41.17 (PA3); also elsewhere on the board
UART_TX: R410.1; also elsewhere on the board
VBAT_TVS: R47.2; also elsewhere on the board

Notes on the sheet:
Voltage divider on ADC input pin
STM32F410RBT6
MCU Power
MCU IO

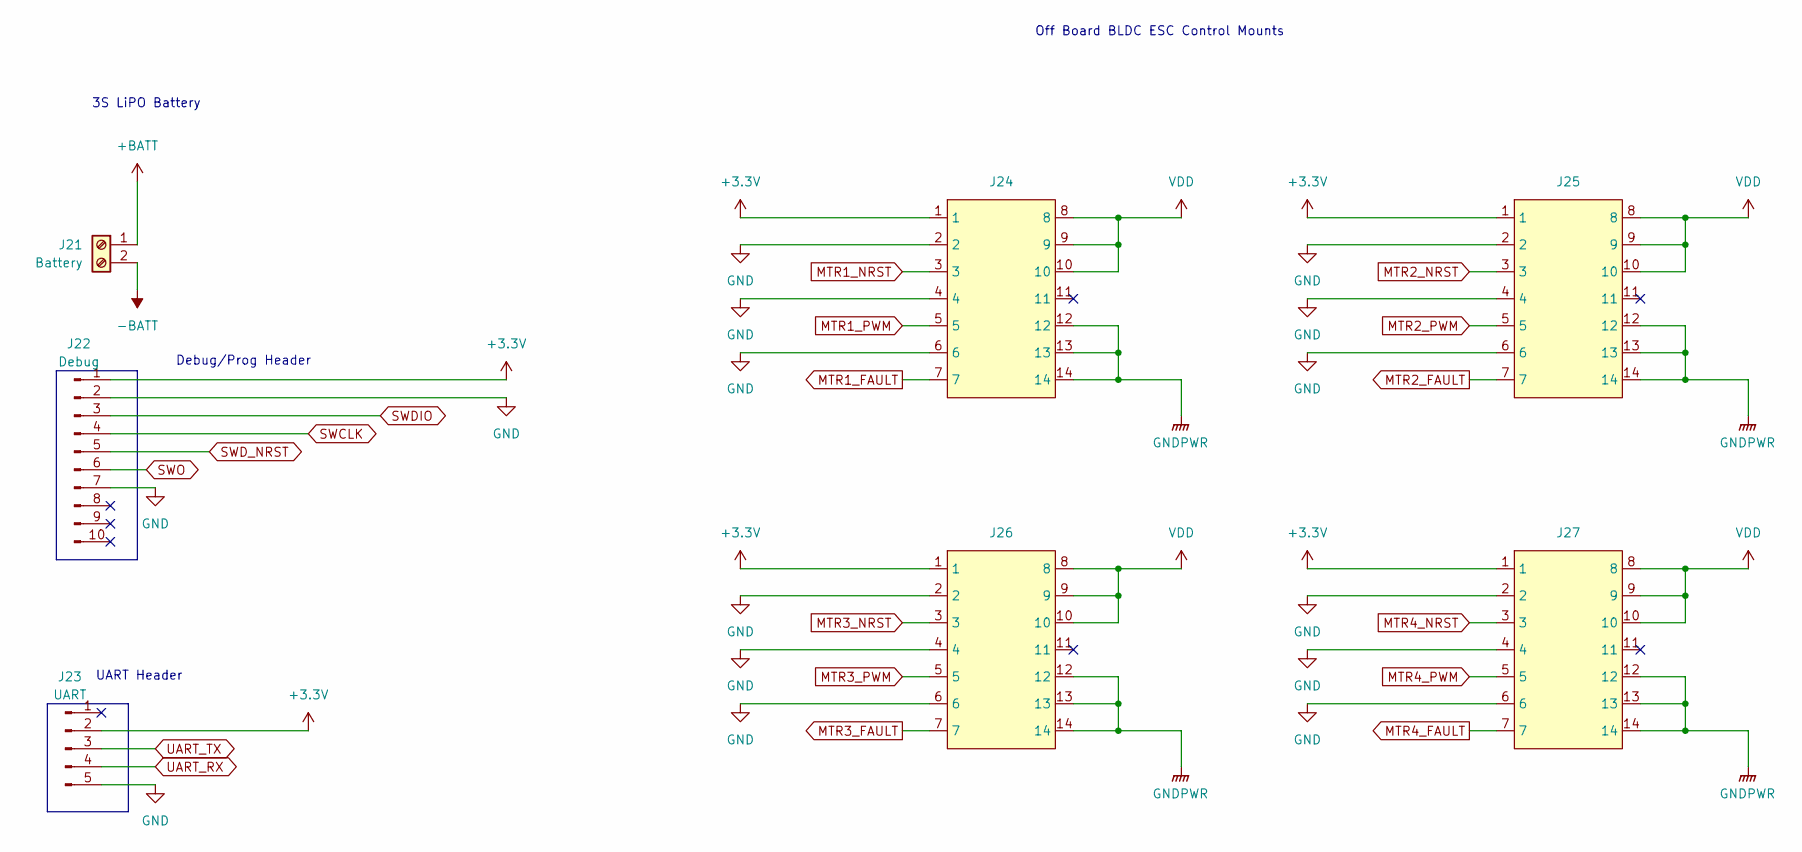
[picture p15: schematic Connectors.kicad_sch]

Parts:
J21: Battery; CUI_TB002-500-02BE
J22: Debug; PinHeader_2x05_P2.54mm_Vertical
J23: UART; PinHeader_1x05_P2.54mm_Vertical
J24, J25, J26, J27: BrushlessESC

Connections:
+3.3V: J22.1, J23.2, J24.1, J25.1, J26.1, J27.1; also elsewhere on the board
+BATT: J21.1; also elsewhere on the board
-BATT: J21.2; also elsewhere on the board
GND: J22.2, J22.7, J23.5, J24.2, J24.4, J24.6, J25.2, J25.4, J25.6, J26.2, J26.4, J26.6, J27.2, J27.4, J27.6; also elsewhere on the board
GNDPWR: J24.12, J24.13, J24.14, J25.12, J25.13, J25.14, J26.12, J26.13, J26.14, J27.12, J27.13, J27.14; also elsewhere on the board
MTR1_FAULT: J24.7; also elsewhere on the board
MTR1_NRST: J24.3; also elsewhere on the board
MTR1_PWM: J24.5; also elsewhere on the board
MTR2_FAULT: J25.7; also elsewhere on the board
MTR2_NRST: J25.3; also elsewhere on the board
MTR2_PWM: J25.5; also elsewhere on the board
MTR3_FAULT: J26.7; also elsewhere on the board
MTR3_NRST: J26.3; also elsewhere on the board
MTR3_PWM: J26.5; also elsewhere on the board
MTR4_FAULT: J27.7; also elsewhere on the board
MTR4_NRST: J27.3; also elsewhere on the board
MTR4_PWM: J27.5; also elsewhere on the board
SWCLK: J22.4; also elsewhere on the board
SWDIO: J22.3; also elsewhere on the board
SWD_NRST: J22.5; also elsewhere on the board
SWO: J22.6; also elsewhere on the board
UART_RX: J23.4; also elsewhere on the board
UART_TX: J23.3; also elsewhere on the board
VDD: J24.8, J24.9, J24.10, J25.8, J25.9, J25.10, J26.8, J26.9, J26.10, J27.8, J27.9, J27.10; also elsewhere on the board

Notes on the sheet:
UART Header
Debug/Prog Header
Off Board BLDC ESC Control Mounts
3S LiPO Battery

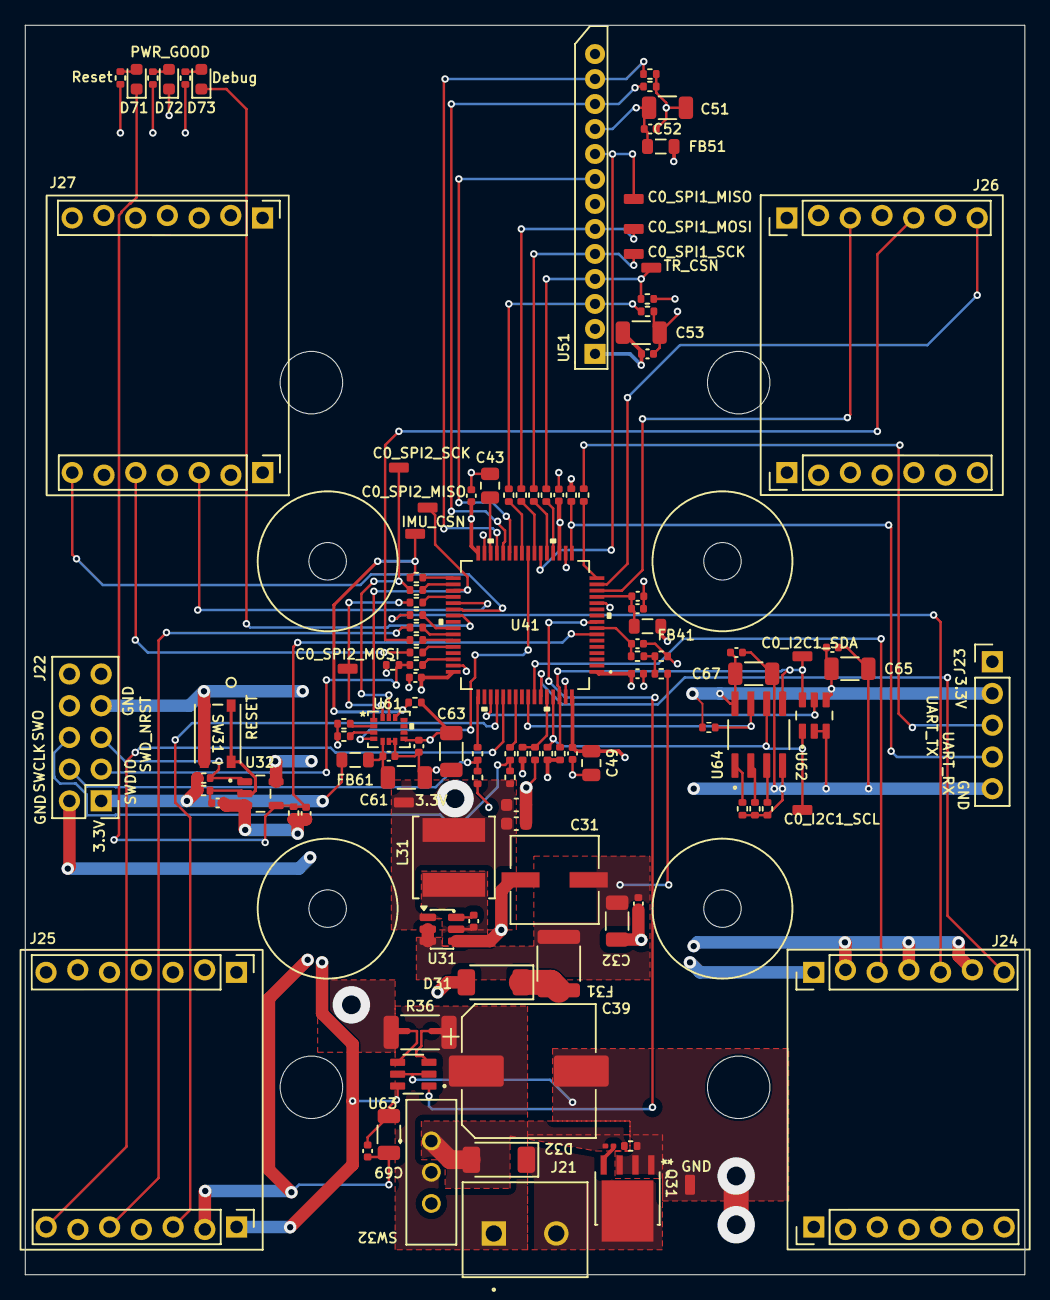
[picture p16: board DroneProject.kicad_pcb from above]

Board: 4 copper layers, 80.0 x 100.0 mm, 130 parts (0 on the bottom side), 83 nets.
