TanvKT/DroneProjectHardware/DroneBrushlessESC/DroneBrushlessESC.kicad_pcb

## KiCad design DroneBrushlessESC/DroneBrushlessESC.kicad_pcb (2026-02-22)

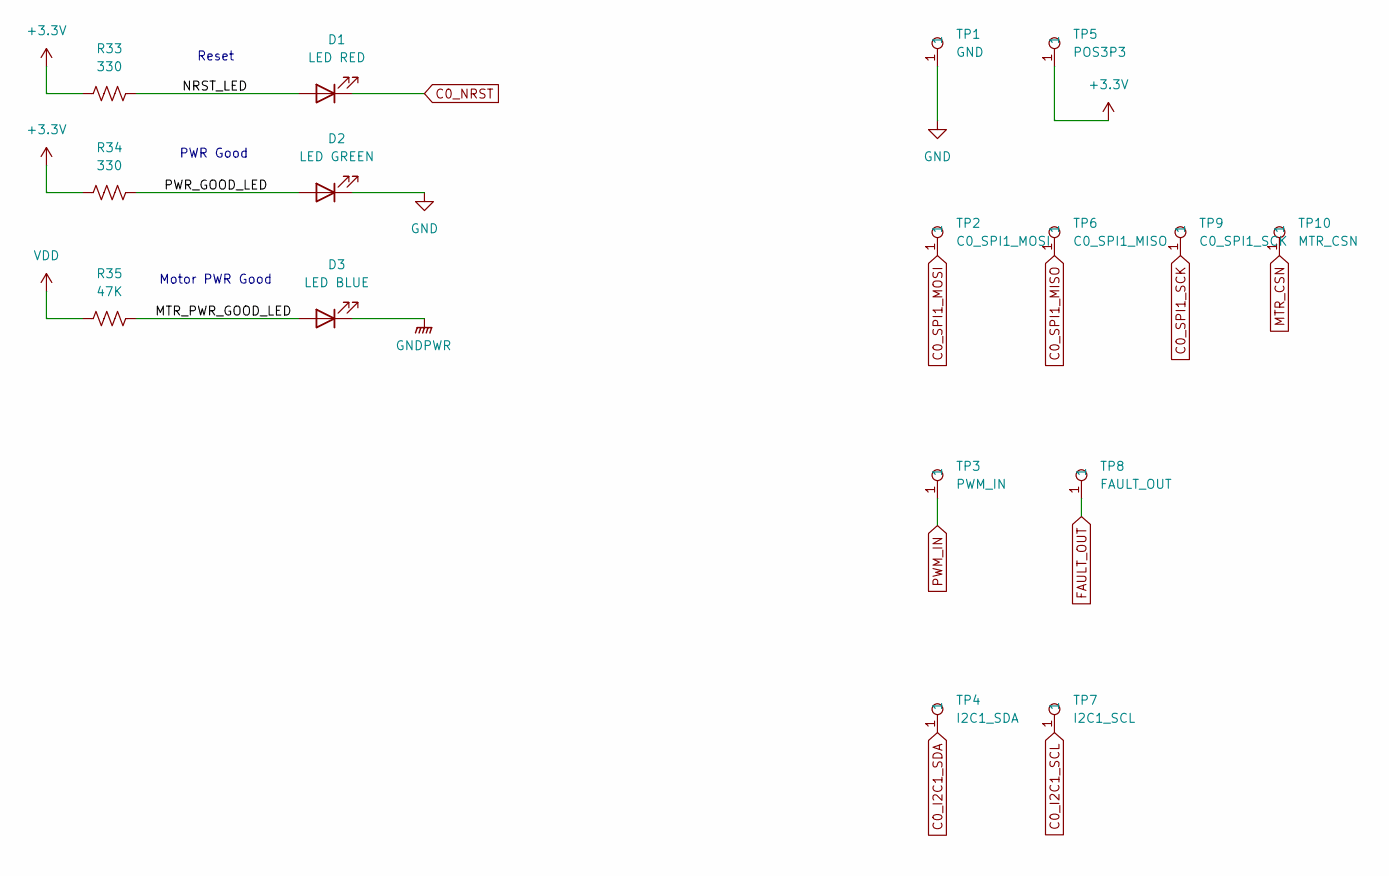
[picture p17: schematic Debug.kicad_sch]

Parts:
D1: LED RED; LED_0603_1608Metric
D2: LED GREEN; LED_0603_1608Metric
D3: LED BLUE; LED_0603_1608Metric
R33, R34: 330; R_0402_1005Metric
R35: 47K; R_0402_1005Metric
TP1: GND; Testpoint 1.6mm x 0.8mm
TP2: C0_SPI1_MOSI; Testpoint 1.6mm x 0.8mm
TP3: PWM_IN; Testpoint 1.6mm x 0.8mm
TP4: I2C1_SDA; Testpoint 1.6mm x 0.8mm
TP5: POS3P3; Testpoint 1.6mm x 0.8mm
TP6: C0_SPI1_MISO; Testpoint 1.6mm x 0.8mm
TP7: I2C1_SCL; Testpoint 1.6mm x 0.8mm
TP8: FAULT_OUT; Testpoint 1.6mm x 0.8mm
TP9: C0_SPI1_SCK; Testpoint 1.6mm x 0.8mm
TP10: MTR_CSN; Testpoint 1.6mm x 0.8mm

Connections:
+3.3V: R33.1, R34.1, TP5.1; also elsewhere on the board
/Debug/MTR_PWR_GOOD_LED: D3.2 (A), R35.2
/Debug/NRST_LED: D1.2 (A), R33.2
/Debug/PWR_GOOD_LED: D2.2 (A), R34.2
C0_I2C1_SCL: TP7.1; also elsewhere on the board
C0_I2C1_SDA: TP4.1; also elsewhere on the board
C0_NRST: D1.1 (K); also elsewhere on the board
C0_SPI1_MISO: TP6.1; also elsewhere on the board
C0_SPI1_MOSI: TP2.1; also elsewhere on the board
C0_SPI1_SCK: TP9.1; also elsewhere on the board
FAULT_OUT: TP8.1; also elsewhere on the board
GND: D2.1 (K), TP1.1; also elsewhere on the board
GNDPWR: D3.1 (K); also elsewhere on the board
MTR_CSN: TP10.1; also elsewhere on the board
PWM_IN: TP3.1; also elsewhere on the board
VDD: R35.1; also elsewhere on the board

Notes on the sheet:
Reset
PWR Good
Motor PWR Good

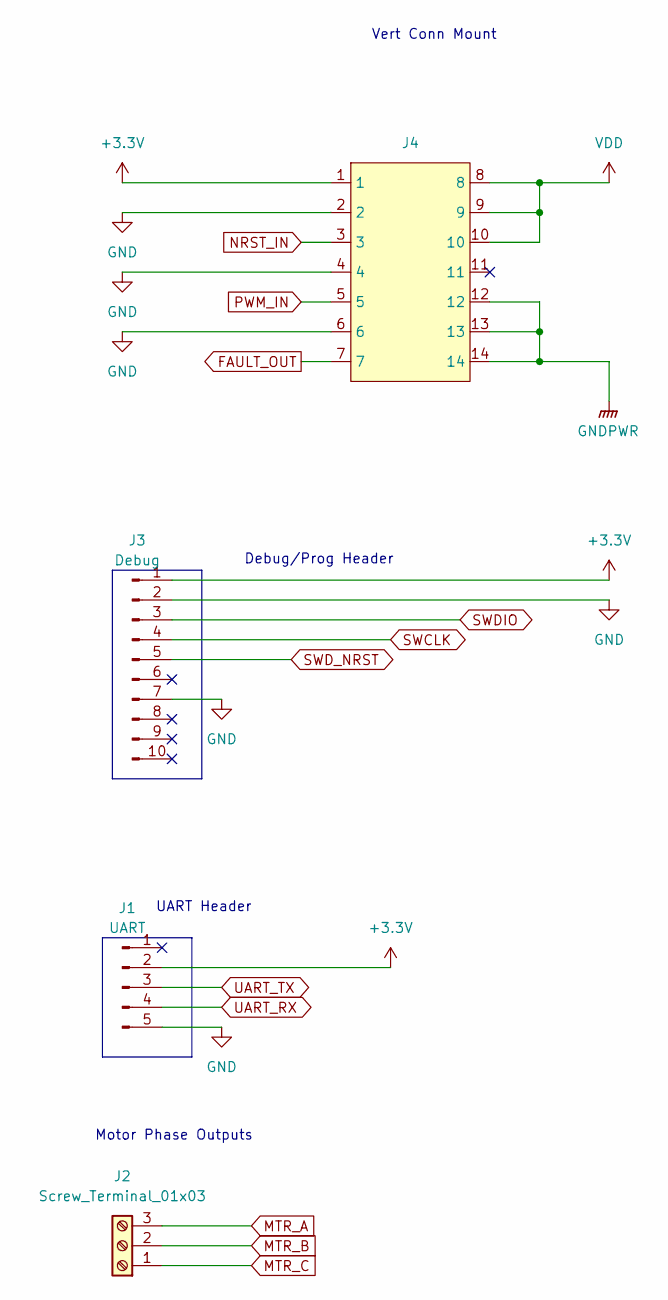
[picture p18: schematic Connectors.kicad_sch]

Parts:
J1: UART; PinHeader_1x05_P2.54mm_Vertical
J2: Screw_Terminal_01x03; CUI_TB005_-762-03BE
J3: Debug; PinHeader_2x05_P2.54mm_Vertical
J4: BrushlessESC

Connections:
+3.3V: J1.2, J3.1, J4.1; also elsewhere on the board
FAULT_OUT: J4.7; also elsewhere on the board
GND: J1.5, J3.2, J3.7, J4.2, J4.4, J4.6; also elsewhere on the board
GNDPWR: J4.12, J4.13, J4.14; also elsewhere on the board
MTR_A: J2.3; also elsewhere on the board
MTR_B: J2.2; also elsewhere on the board
MTR_C: J2.1; also elsewhere on the board
NRST_IN: J4.3; also elsewhere on the board
PWM_IN: J4.5; also elsewhere on the board
SWCLK: J3.4; also elsewhere on the board
SWDIO: J3.3; also elsewhere on the board
SWD_NRST: J3.5; also elsewhere on the board
UART_RX: J1.4; also elsewhere on the board
UART_TX: J1.3; also elsewhere on the board
VDD: J4.8, J4.9, J4.10; also elsewhere on the board

Notes on the sheet:
Motor Phase Outputs
UART Header
Debug/Prog Header
Vert Conn Mount

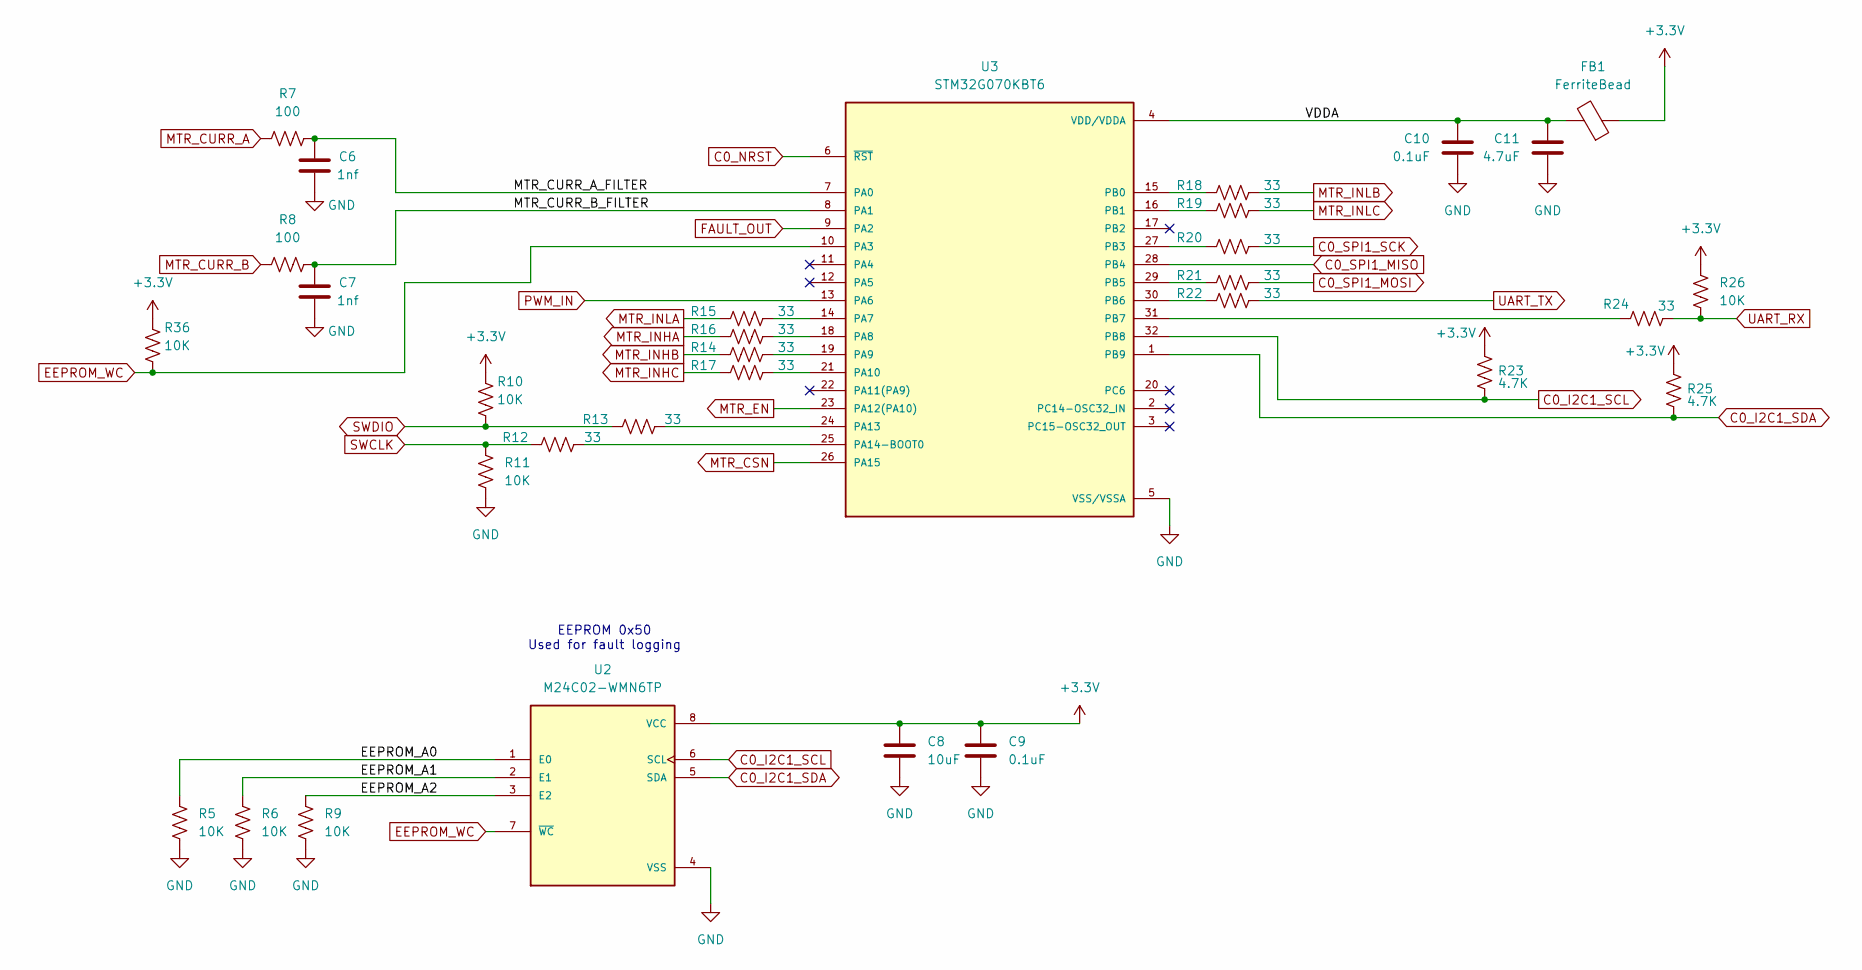
[picture p19: schematic MCU.kicad_sch]

Parts:
C6, C7: 1nf; C_0402_1005Metric
C8: 10uF; C_1206_3216Metric
C9, C10: 0.1uF; C_0402_1005Metric
C11: 4.7uF; C_0805_2012Metric
FB1: FerriteBead; L_0805_2012Metric
R5, R6, R9, R10, R11, R26, R36: 10K; R_0402_1005Metric
R7, R8: 100; R_0402_1005Metric
R12, R13, R14, R15, R16, R17, R18, R19, R20, R21, R22, R24: 33; R_0402_1005Metric
R23, R25: 4.7K; R_0402_1005Metric
U2: M24C02-WMN6TP; SOIC127P600X175-8N; PARTREV 8
U3: STM32G070KBT6; QFP80P900X900X160-32N; PARTREV 2

Connections:
+3.3V: C8.1, C9.1, FB1.1, R10.2, R23.2, R25.2, R26.2, R36.2, U2.8 (VCC); also elsewhere on the board
/MCU/EEPROM_A0: R5.2, U2.1 (E0)
/MCU/EEPROM_A1: R6.2, U2.2 (E1)
/MCU/EEPROM_A2: R9.2, U2.3 (E2)
/MCU/MTR_CURR_A_FILTER: C6.1, R7.2, U3.7 (PA0)
/MCU/MTR_CURR_B_FILTER: C7.1, R8.2, U3.8 (PA1)
/MCU/VDDA: C10.1, C11.1, FB1.2, U3.4 (VDD/VDDA)
C0_I2C1_SCL: R23.1, U2.6 (SCL), U3.32 (PB8); also elsewhere on the board
C0_I2C1_SDA: R25.1, U2.5 (SDA), U3.1 (PB9); also elsewhere on the board
C0_NRST: U3.6 (~RST); also elsewhere on the board
C0_SPI1_MISO: U3.28 (PB4); also elsewhere on the board
C0_SPI1_MOSI: R21.2; also elsewhere on the board
C0_SPI1_SCK: R20.2; also elsewhere on the board
EEPROM_WC: R36.1, U2.7 (~WC), U3.10 (PA3)
FAULT_OUT: U3.9 (PA2); also elsewhere on the board
GND: C6.2, C7.2, C8.2, C9.2, C10.2, C11.2, R5.1, R6.1, R9.1, R11.1, U2.4 (VSS), U3.5 (VSS/VSSA); also elsewhere on the board
MTR_CSN: U3.26 (PA15); also elsewhere on the board
MTR_CURR_A: R7.1; also elsewhere on the board
MTR_CURR_B: R8.1; also elsewhere on the board
MTR_EN: U3.23 (PA12(PA10)); also elsewhere on the board
MTR_INHA: R16.1; also elsewhere on the board
MTR_INHB: R14.1; also elsewhere on the board
MTR_INHC: R17.1; also elsewhere on the board
MTR_INLA: R15.1; also elsewhere on the board
MTR_INLB: R18.2; also elsewhere on the board
MTR_INLC: R19.2; also elsewhere on the board
unnamed: R15.2, U3.14 (PA7)
unnamed: R16.2, U3.18 (PA8)
unnamed: R14.2, U3.19 (PA9)
unnamed: R17.2, U3.21 (PA10)
unnamed: R13.2, U3.24 (PA13)
unnamed: R12.2, U3.25 (PA14-BOOT0)
unnamed: R18.1, U3.15 (PB0)
unnamed: R19.1, U3.16 (PB1)
unnamed: R20.1, U3.27 (PB3)
unnamed: R21.1, U3.29 (PB5)
unnamed: R22.1, U3.30 (PB6)
unnamed: R24.1, U3.31 (PB7)
PWM_IN: U3.13 (PA6); also elsewhere on the board
SWCLK: R11.2, R12.1; also elsewhere on the board
SWDIO: R10.1, R13.1; also elsewhere on the board
UART_RX: R24.2, R26.1; also elsewhere on the board
UART_TX: R22.2; also elsewhere on the board

Notes on the sheet:
EEPROM 0x50 Used for fault logging

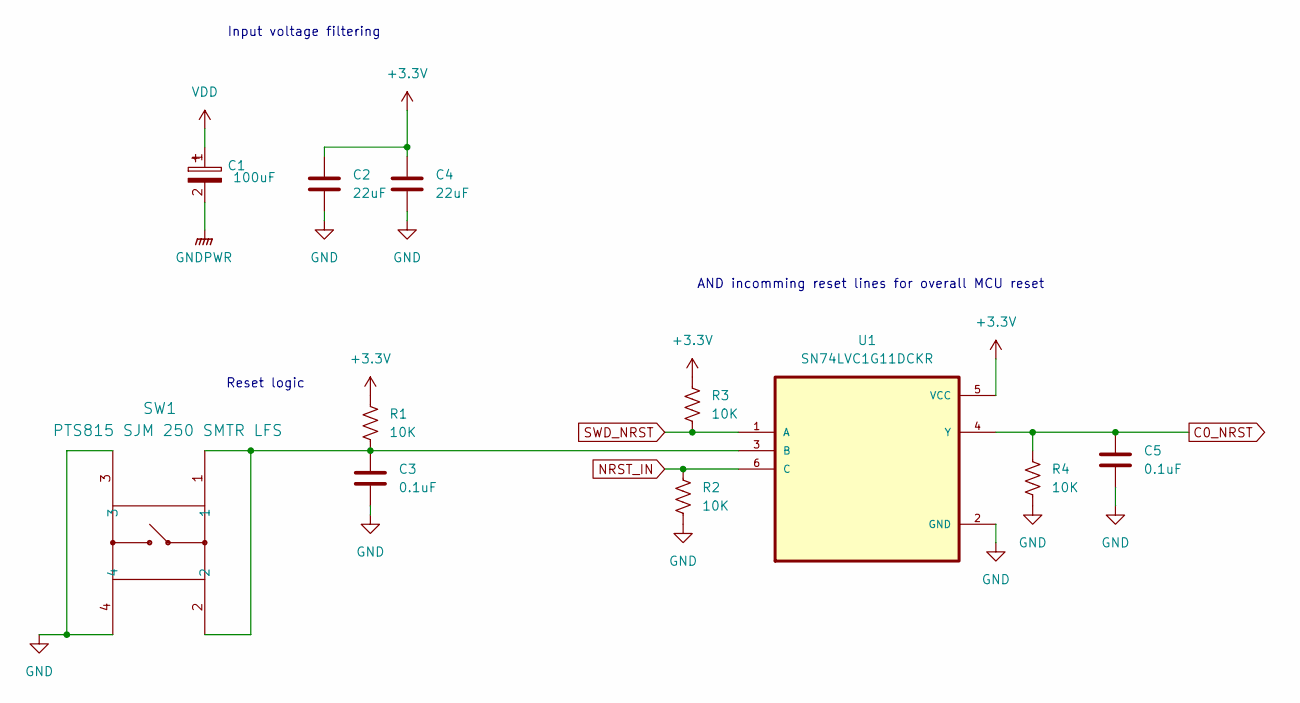
[picture p20: schematic Power.kicad_sch]

Parts:
C1: 100uF; CAP_A768EB_6.8x6.8_KEM
C2, C4: 22uF; C_0603_1608Metric
C3, C5: 0.1uF; C_0402_1005Metric
R1, R2, R3, R4: 10K; R_0402_1005Metric
SW1: PTS815 SJM 250 SMTR LFS; SW4_PTS815 SJM 250 SMTR LFS_CNK
U1: SN74LVC1G11DCKR; SOT65P210X110-6N

Connections:
+3.3V: C2.1, C4.1, R1.2, R3.2, U1.5 (VCC); also elsewhere on the board
C0_NRST: C5.1, R4.2, U1.4 (Y); also elsewhere on the board
GND: C2.2, C3.2, C4.2, C5.2, R2.1, R4.1, SW1.3, SW1.4, U1.2 (GND); also elsewhere on the board
GNDPWR: C1.2; also elsewhere on the board
NRST_IN: R2.2, U1.6 (C); also elsewhere on the board
unnamed: C3.1, R1.1, SW1.1, SW1.2, U1.3 (B)
SWD_NRST: R3.1, U1.1 (A); also elsewhere on the board
VDD: C1.1; also elsewhere on the board

Notes on the sheet:
AND incomming reset lines for overall MCU reset
Input voltage filtering
Reset logic
