TanvKT/DroneProjectHardware/DroneBrushlessESC/DroneBrushlessESC.kicad_pcb

## KiCad design DroneBrushlessESC/DroneBrushlessESC.kicad_pcb (continued)

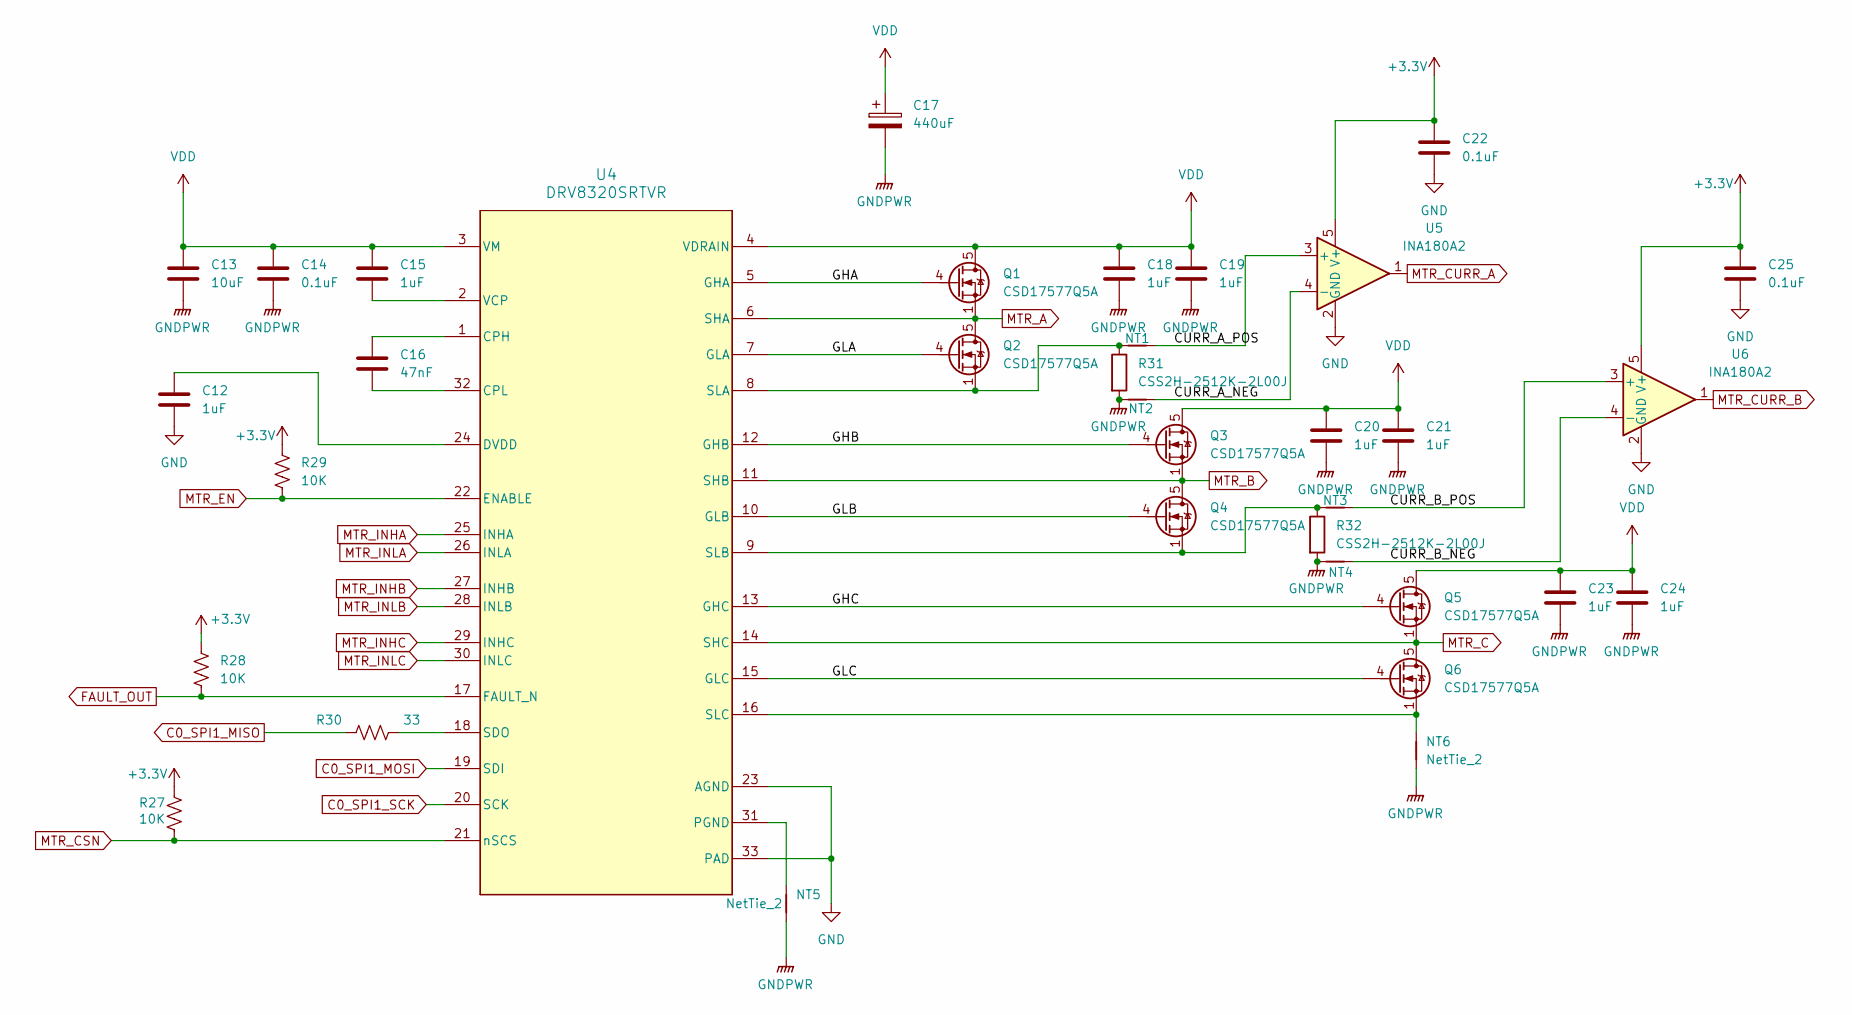
[picture p21: schematic Motor.kicad_sch]

Parts:
C12, C15: 1uF; C_0402_1005Metric
C13: 10uF; C_1206_3216Metric
C14, C22, C25: 0.1uF; C_0402_1005Metric
C16: 47nF; C_0402_1005Metric
C17: 440uF; CP_Radial_D10.0mm_P5.00mm
C18, C19, C20, C21, C23, C24: 1uF; C_0603_1608Metric
NT1, NT2, NT3, NT4, NT5, NT6: NetTie_2; NetTie-2_SMD_Pad0.5mm
Q1, Q2, Q3, Q4, Q5, Q6: CSD17577Q5A; TDSON-8-1
R27, R28, R29: 10K; R_0402_1005Metric
R30: 33; R_0402_1005Metric
R31, R32: CSS2H-2512K-2L00J; R_2512_6332Metric
U4: DRV8320SRTVR
U5, U6: INA180A2; SOT-23-5

Connections:
+3.3V: C22.1, C25.1, R27.2, R28.2, R29.2, U5.5 (V+), U6.5 (V+); also elsewhere on the board
/Motor/CURR_A_NEG: NT2.2, U5.4 (-)
/Motor/CURR_A_POS: NT1.2, U5.3 (+)
/Motor/CURR_B_NEG: NT4.2, U6.4 (-)
/Motor/CURR_B_POS: NT3.2, U6.3 (+)
/Motor/GHA: Q1.4 (G), U4.5 (GHA)
/Motor/GHB: Q3.4 (G), U4.12 (GHB)
/Motor/GHC: Q5.4 (G), U4.13 (GHC)
/Motor/GLA: Q2.4 (G), U4.7 (GLA)
/Motor/GLB: Q4.4 (G), U4.10 (GLB)
/Motor/GLC: Q6.4 (G), U4.15 (GLC)
C0_SPI1_MISO: R30.1; also elsewhere on the board
C0_SPI1_MOSI: U4.19 (SDI); also elsewhere on the board
C0_SPI1_SCK: U4.20 (SCK); also elsewhere on the board
FAULT_OUT: R28.1, U4.17 (FAULT_N); also elsewhere on the board
GND: C12.2, C22.2, C25.2, U4.23 (AGND), U4.33 (PAD), U5.2 (GND), U6.2 (GND); also elsewhere on the board
GNDPWR: C13.2, C14.2, C17.2, C18.2, C19.2, C20.2, C21.2, C23.2, C24.2, NT2.1, NT4.1, NT5.1, NT6.1, R31.2, R32.2; also elsewhere on the board
MTR_A: Q1.1 (S), Q1.2 (S), Q1.3 (S), Q2.5 (D), U4.6 (SHA); also elsewhere on the board
MTR_B: Q3.1 (S), Q3.2 (S), Q3.3 (S), Q4.5 (D), U4.11 (SHB); also elsewhere on the board
MTR_C: Q5.1 (S), Q5.2 (S), Q5.3 (S), Q6.5 (D), U4.14 (SHC); also elsewhere on the board
MTR_CSN: R27.1, U4.21 (nSCS); also elsewhere on the board
MTR_CURR_A: U5.1; also elsewhere on the board
MTR_CURR_B: U6.1; also elsewhere on the board
MTR_EN: R29.1, U4.22 (ENABLE); also elsewhere on the board
MTR_INHA: U4.25 (INHA); also elsewhere on the board
MTR_INHB: U4.27 (INHB); also elsewhere on the board
MTR_INHC: U4.29 (INHC); also elsewhere on the board
MTR_INLA: U4.26 (INLA); also elsewhere on the board
MTR_INLB: U4.28 (INLB); also elsewhere on the board
MTR_INLC: U4.30 (INLC); also elsewhere on the board
unnamed: C16.2, U4.1 (CPH)
unnamed: C16.1, U4.32 (CPL)
unnamed: C12.1, U4.24 (DVDD)
unnamed: NT5.2, U4.31 (PGND)
unnamed: R30.2, U4.18 (SDO)
unnamed: NT1.1, Q2.1 (S), Q2.2 (S), Q2.3 (S), R31.1, U4.8 (SLA)
unnamed: NT3.1, Q4.1 (S), Q4.2 (S), Q4.3 (S), R32.1, U4.9 (SLB)
unnamed: NT6.2, Q6.1 (S), Q6.2 (S), Q6.3 (S), U4.16 (SLC)
unnamed: C15.2, U4.2 (VCP)
VDD: C13.1, C14.1, C15.1, C17.1, C18.1, C19.1, C20.1, C21.1, C23.1, C24.1, Q1.5 (D), Q3.5 (D), Q5.5 (D), U4.3 (VM), U4.4 (VDRAIN); also elsewhere on the board

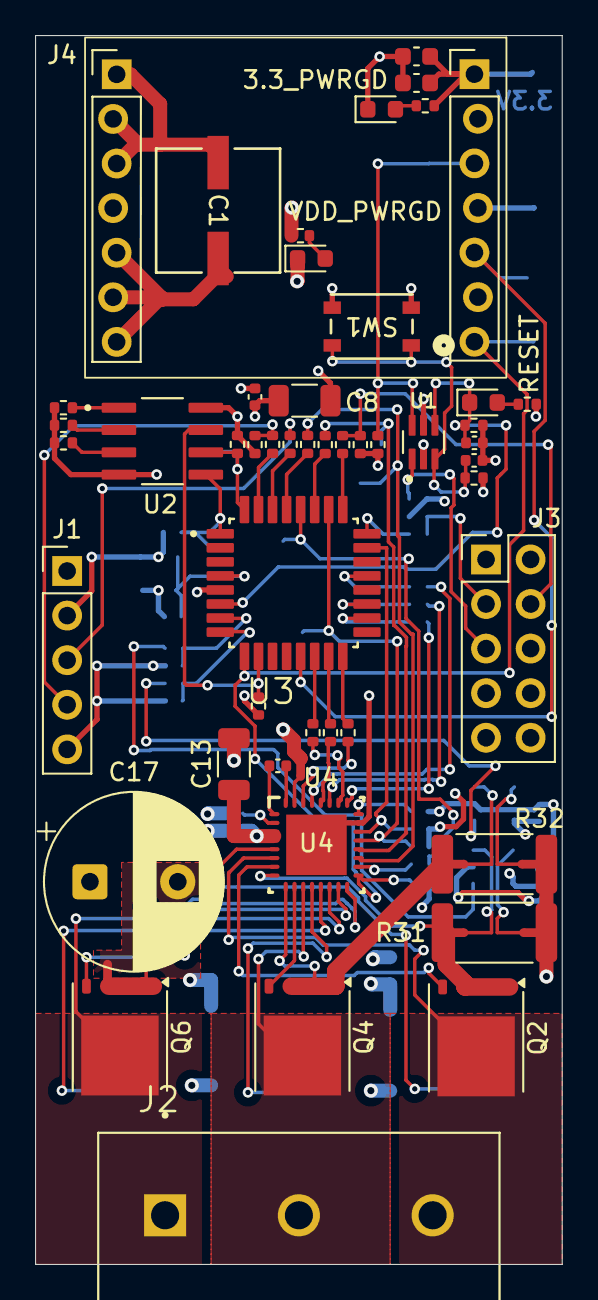
[picture p22: board DroneBrushlessESC.kicad_pcb from above]

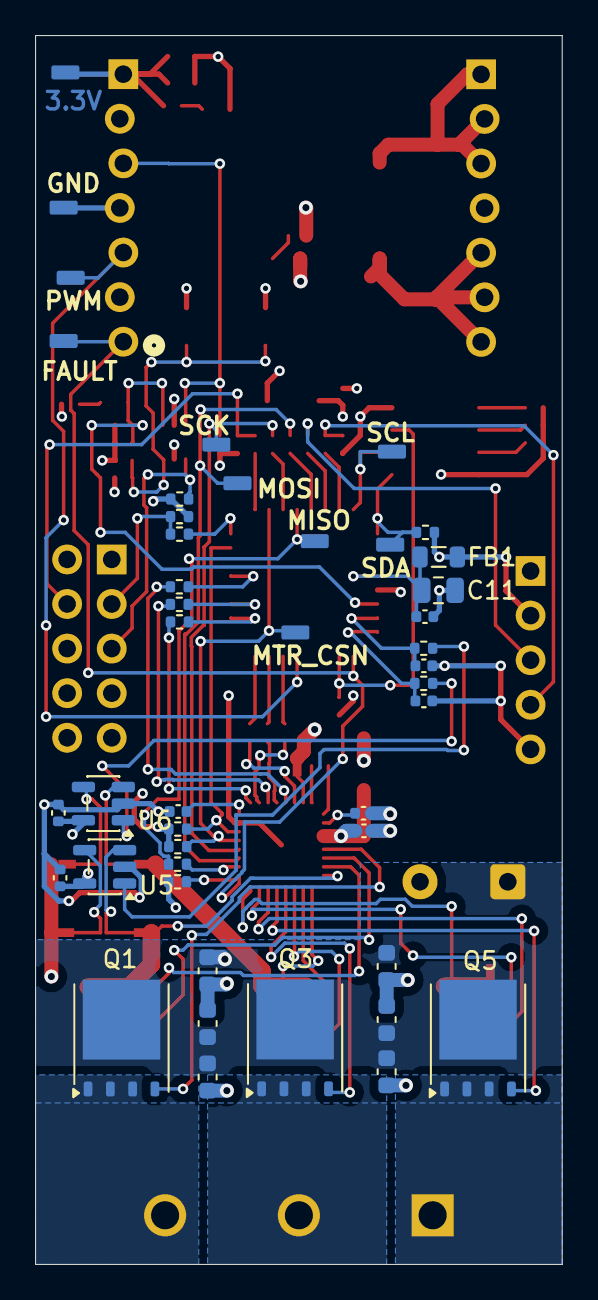
[picture p23: board DroneBrushlessESC.kicad_pcb from below]

Board: 4 copper layers, 30.0 x 70.0 mm, 98 parts (44 on the bottom side), 73 nets.
