TanvKT/DroneProjectHardware/(commit log)

2026-01-28 Base Project
    [DroneProject.kicad_pcb, DroneProject.kicad_sch]
2026-02-01 Initial Prototype Schematic for testing MCU and various sensors complete
    [Connectors.kicad_sch, Debug.kicad_sch, DroneProject.kicad_sch, MCU.kicad_sch, Power.kicad_sch, Sensors.kicad_sch, Transciever.kicad_sch]
2026-02-01 Added test points
    [Debug.kicad_sch, Sensors.kicad_sch]
2026-02-03 Added mounting holes and some more testpoints. Also started on PCB with dimesions and mounting holes measured and placed
    [Connectors.kicad_sch, Debug.kicad_sch, DroneProject.kicad_pcb, DroneProject.kicad_sch, MCU.kicad_sch, Power.kicad_sch, Sensors.kicad_sch]
2026-02-05 Finished initial PCB layout. However decided to go ahead and add the motor drivers for the first prototype anyways. Re-did the reverse-polarity detection to use an NMOS instead of a PMOS. Added sheet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
    [Connectors.kicad_sch, Debug.kicad_sch, DroneProject.kicad_pcb, DroneProject.kicad_sch, Power.kicad_sch, Sensors.kicad_sch, Transciever.kicad_sch]
2026-02-05 Re-did layout for new power system
    [DroneProject.kicad_pcb, DroneProject.kicad_sch, Motor_1.kicad_sch, Motor_2.kicad_sch, Motor_3.kicad_sch, Motor_4.kicad_sch, Power.kicad_sch, Sensors.kicad_sch]
2026-02-08 Added a second MCU for motor control. Removed 5V rail. Added COM switching for SWD and UART external headers
    [Connectors.kicad_sch, Debug.kicad_sch, DroneProject.kicad_pcb, DroneProject.kicad_sch, MCU.kicad_sch, Motor_1.kicad_sch, Motor_2.kicad_sch, Motor_3.kicad_sch]
2026-02-09 Changed motor controller to higher pin count MCU. Defined all the pins for 3x PWM control over 4 motors. Renamed a couple of global IO signals to indicate MCU origin (C0 vs C1)
    [Debug.kicad_sch, MCU.kicad_sch, Motor_Control.kicad_sch, Prog.kicad_sch, Sensors.kicad_sch, Transciever.kicad_sch]
2026-02-11 Finished motor and C1 designs, still need to rename components on MTR2, 3, and 4 pages
    [Connectors.kicad_sch, MCU.kicad_sch, Motor_1.kicad_sch, Motor_2.kicad_sch, Motor_3.kicad_sch, Motor_4.kicad_sch, Motor_Control.kicad_sch, Prog.kicad_sch]
2026-02-18 Finished most of routing for motor controls, however likely going to revert back and make separate ESC boards for motor control as I think that would honestly be more efficient from both a cost and d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
    [Connectors.kicad_sch, DroneProject.kicad_pcb, MCU.kicad_sch, Motor_1.kicad_sch, Motor_2.kicad_sch, Motor_3.kicad_sch, Motor_4.kicad_sch, Motor_Control.kicad_sch]
2026-02-18 Removed C1 and motor controllers from main platform and moved to own project
    [Connectors.kicad_sch, DroneBrushlessESC.kicad_pcb, DroneBrushlessESC.kicad_sch, DroneProject.kicad_pcb, DroneProject.kicad_sch, MCU.kicad_sch, Motor.kicad_sch, Power.kicad_sch]
2026-02-19 Completed schematic for brushless ESC and added needed components to main board. The plan is to mount the ESCs on the main board using 2.54mm Vert Conn Headers
    [Connectors.kicad_sch, Debug.kicad_sch, DroneBrushlessESC.kicad_sch, DroneProject.kicad_pcb, MCU.kicad_sch, Motor.kicad_sch, Power.kicad_sch, Sensors.kicad_sch]
2026-02-20 Finished layout for controller board
    [Connectors.kicad_sch, Debug.kicad_sch, DroneBrushlessESC.kicad_pcb, DroneProject.kicad_pcb, MCU.kicad_sch, Motor.kicad_sch, Power.kicad_sch]
2026-02-22 Finished brushless driver layout
    [Connectors.kicad_sch, Debug.kicad_sch, DroneBrushlessESC.kicad_pcb, DroneProject.kicad_pcb, MCU.kicad_sch, Motor.kicad_sch, Power.kicad_sch, Sensors.kicad_sch]
2026-02-24 Finished Schematic for controller
    [Connectors.kicad_sch, Controller.kicad_pcb, Controller.kicad_sch, Debug.kicad_sch, DroneBrushlessESC.kicad_sch, DroneProject.kicad_sch, MCU.kicad_sch, Motor.kicad_sch]
2026-02-24 Finished layout for controller, ready to order REV 0-1 PCBs
    [Connectors.kicad_sch, Controller.kicad_pcb, Debug.kicad_sch, MCU.kicad_sch, Peripherals.kicad_sch, Power.kicad_sch, Transciever.kicad_sch]
2026-02-24 Swapped polarity of joystick and speed dial so that values line up correctly with desired control. In short 3.3V on ADC is max speed rather than no speed.
    [Connectors.kicad_sch, Controller.kicad_pcb, Debug.kicad_sch, MCU.kicad_sch, Peripherals.kicad_sch, Power.kicad_sch, Transciever.kicad_sch]
